60mph/vkr_trng/trng/hardware/01_thermal.md

# Схема №1 — Тепловой шум на 1 МОм + LM358

## BOM

| Поз. | Деталь | Кол-во | Из общего каталога |
|---|---|---|---|
| U1 | LM358P | 1 | да |
| R_n  | Резистор 1 МОм 0.25 Вт 1% | 1 | да |
| R1, R2 | Резистор 10 кОм | 2 | да (делитель V_mid)|
| R_g1 | Резистор 1 кОм | 1 | да (gain каскада 1)|
| R_f1 | Резистор 1 МОм | 1 | да (gain каскада 1)|
| R_g2 | Резистор 10 кОм | 1 | да (gain каскада 2)|
| R_f2 | Резистор 1 МОм | 1 | да (gain каскада 2)|
| C1 | Электролит 10 мкФ | 1 | да (V_mid bypass)  |
| C2 | Электролит 10 мкФ | 1 | да (AC-связь) |
| C3 | Керамика 0.1 мкФ | 1 | да (питание U1) |

Итого: 1× LM358, 7× резисторов, 2× электролита, 1× керамика.

## Расчёт коэффициента усиления

- Каскад 1 (неинвертирующий): Au1 = 1 + R_f1/R_g1 = 1 + 1 МОм / 1 кОм = **1001**.
- Каскад 2 (неинвертирующий): Au2 = 1 + R_f2/R_g2 = 1 + 1 МОм / 10 кОм = **101**.
- Итого Au = ~10⁵.

При e_t = 12,8 мкВ_rms (R=1 МОм, Δf=10 кГц, T=300 К) на выходе ожидаем
≈ 1,3 В_rms. У **LM358** при +5 В верхняя граница выхода типично **V_cc − 1,5 В**
(≈3,5 В), поэтому положительные полупериоды около V_mid могут **слегка клипповать** —
см. «Известные проблемы». При перегрузе уменьшайте Au (например R_f1 = 100 кОм).

## Принципиальная схема (ASCII)

```
              5V o─────┬──── R1 (10k) ──┬──── R2 (10k) ───┐
                       │                │                  │
                       │                │  V_mid = 2.5V    │
                       │                ├── C1 (10µF) ─── GND
                       │                │
                       │                │                ┌── 5V
                       │                │   ┌────────────┤
                       │                │   │  LM358(A)  │
              R_n      │   ┌── R_g1 ──┐ │   │            │
        ┌── (1M) ──┐   │   │          │ │   │ 1: OUT_A ──┼── через C2 (10µF) ── R_g2(10k) ─┐
   GND──┤          ├───┴───┤+IN(3) ───┘ │   │ 2: -IN_A ──┘                                  │
        │          │           │        │   │ 3: +IN_A ────────────────────────────────────│
        └──────────┘           └── R_f1(1M) ┤ 4: V-(GND) │                                  │
                                            │ 5: +IN_B ──┐                                  │
                                            │ 6: -IN_B ──┤                                  │
                                            │ 7: OUT_B ──┴── к A0 Arduino                   │
                                            │ 8: V+(5V) ─── C3(0.1µF) ── GND                │
                                            └─────────────┘                                  │
                                                          R_f2(1M) ─────────── -IN_B────────┘
```

## Сборка по шагам

1. Установите LM358 в DIP-8 разъём на MB-102 (между разделами).
2. Сформируйте V_mid: R1, R2 (делитель 5В→2,5В), C1 (10µF) от V_mid к GND.
3. Соберите источник теплового шума: один вывод R_n к GND, другой — к +IN_A
   (пин 3) **через короткие соединения** и **обязательно экранированный
   участок макетной платы** (например, обнесите проводом, заземлённым на GND).
4. Резистор обратной связи R_f1 (1 МОм) между OUT_A (1) и -IN_A (2).
5. R_g1 (1 кОм) между -IN_A (2) и V_mid.
6. AC-связь C2 (10µF, плюс к выходу 1, минус — к R_g2). С другой стороны
   R_g2 — к -IN_B (6). +IN_B (5) — к V_mid.
7. R_f2 (1 МОм) между OUT_B (7) и -IN_B (6).
8. OUT_B (7) → A0 Arduino.
9. **Питание U1**: V+ (8) → 5V, V- (4) → GND, керамика 0,1µF между 8 и GND
   максимально близко к корпусу.

## Проверка перед запуском

- Мультиметром: на V_mid — 2,5 В ± 0,1.
- На OUT_A в покое — 2,5 В ± 0,5 (не должен прижиматься к 0 или 5).
- На OUT_B в покое — 2,5 В ± 0,5.
- Осциллограф (если есть) на OUT_B: ожидаемая амплитуда ~0,5...2,5 В пик-пик
  при +5 В и LM358 (запас до верха рельсы ~3,5 В); при клиппинге снизить Au.

## Известные проблемы

- **Выход LM358 не доходит до +5 В**: типично максимум **~V_cc − 1,5 В**. Смещение
  на **V_mid ≈ 2,5 В** остаётся корректным; при клиппинге сверху уменьшить Au или
  подобрать R_f1/R_f2.
- **Входной ток смещения** LM358 (намного выше, чем у JFET-ОУ) на **мегомном**
  узле **+IN_A** даёт **DC-сдвиг** — при необходимости добавьте подтяжку **V_mid → +IN_A**
  высоким R (см. обсуждение в README/сборке) или уменьшите номинал R_n-ветки по приоритету шума.
- **Самовозбуждение / шум питания** при слабой развязке. Помогает: увеличить C3 до
  1 мкФ керамики, ставить дополнительный 10 мкФ электролит у +5В.
- **Сетевая наводка 50 Гц**. Помогает: укоротить провода R_n до 1–2 см,
  переместить плату подальше от блоков питания, отключить заряжающее USB на
  ноутбуке.
- **Насыщение** одного из каскадов — на выходе постоянно 0 или у верхнего потолка
  LM358. Уменьшить Au_total до 10⁴ (**R_f1 = 100 кОм**), убедиться, что V_mid стабилен.
