60mph/vkr_trng/trng/hardware/02_zener.md

# Схема №2 — Шум стабилитрона 5,1 В

## BOM

| Поз. | Деталь | Кол-во |
|---|---|---|
| D1 | Стабилитрон 5,1 В 1 Вт | 1 |
| U1 | LM358P | 1 |
| R_b | Резистор 100 кОм | 1 (балласт стабилитрона) |
| R1, R2  | Резистор 10 кОм | 2 (V_mid) |
| R_g1 | Резистор 1 кОм | 1 |
| R_f1 | Резистор 100 кОм | 1 |
| R_g2 | Резистор 1 кОм | 1 |
| R_f2 | Резистор 10 кОм | 1 |
| C_in | Электролит 10 мкФ (AC-связь источника) | 1 |
| C2 | Электролит 10 мкФ (AC-связь между каскадами) | 1 |
| C1, C3  | Керамика 0,1 мкФ | 2 |

## Расчёт

- I_z = (Vin − U_z) / R_b = (9 − 5,1) / 100k ≈ **39 мкА** — режим в самой
  "шумной" зоне нестабильного пробоя.
- Au1 = 1 + 100k/1k = 101.
- Au2 = 1 + 10k/1k = 11.
- Au_total ≈ 1100 — достаточно, чтобы шум Зенера в десятки мВ_rms попал в
  полосу ADC 0–5 В без насыщения.

## Принципиальная схема

```
   Vin(9V) ──── R_b (100k) ──┬─── катод D1 (5.1V Zener)
                             │       │
                             │      анод D1 ── GND
                             │
                             ├── C_in (10µF, плюс к катоду D1) ─── R_g1 (1k) ──┐
                             │                                                  │
                             │                          LM358(A): +IN_A ←── V_mid
                             │                                  : -IN_A ←──────┤
                             │                                  : OUT_A ──┐    │
                             │                                            │    │
                             │                                R_f1 (100k) │
                             │                                            └────┘
                             │                                  : OUT_A ──── C2 (10µF) ──── R_g2 (1k) ──┐
                             │                                                                          │
                             │                                          LM358(B): +IN_B ←── V_mid     │
                             │                                                : -IN_B ←──────────────── ┤
                             │                                                : OUT_B ──── A0           │
                             │                                                                          │
                             │                                                            R_f2 (10k)    │
                             │                                                                          │
                             └──────────────────────────────────────────────────────────────────────────┘
```

V_mid = 2,5 В формируется делителем R1/R2 + C1 (10 мкФ) на 5 В Arduino.

## Сборка

1. Стабилитрон и R_b — на отдельной паре рельсов "шумной" части макетки,
   подальше от Arduino, чтобы импульсы не наводились на ADC по питанию.
2. Питание 9 В — с пина Vin Arduino (через регулятор Nano выходит на ~ 7,5 В,
   но можно подавать прямо на Vin внешний стабилизированный 9 В).
   **АЛЬТЕРНАТИВА:** питать стабилитрон от батарейки 9 В через тот же R_b,
   полностью развязав её GND с Arduino через конденсатор 100 мкФ.
3. С_in и далее — как в `01_thermal.md`, разница только в номиналах R_f.
4. **ВАЖНО**: между Vin и +5V Arduino желательно поставить ферритовую бусину
   или дроссель, чтобы импульсный шум стабилитрона не попадал на питание AVCC.

## Проверка

- Напряжение на D1 (катод-анод): 4,8...5,4 В (плавает! это норма).
- На OUT_A: ~2,5 В ± 1,0 (видна заметная "флуктуация" даже мультиметром).
- На OUT_B: тот же уровень с ещё большей амплитудой.

## Тонкая настройка

Если шум слишком слабый или сигнал насыщается:

- **Слабый**: увеличить R_b до 220 кОм (точка работает дальше от пробоя),
  затем уменьшить → найти "сладкую зону".
- **Насыщение**: уменьшить R_f1 до 47 кОм, R_f2 до 4,7 кОм.
