60mph/vkr_trng/trng/hardware/08_hybrid.md

# Схема №8 — Гибридный TRNG (уровень 1, на Arduino)

## BOM

Это объединение нескольких источников. Должны быть собраны:

- **MPU-6050** (см. `05_mpu6050.md`).
- **Аналоговый источник на A0**: в этой документации возьмём 02_zener
  (стабилитрон). Но прошивка `08_hybrid` агностична к тому, что именно стоит
  на A0 — можно вместо Зенера подключить тепловой (`01_thermal.md`) или
  BJT (`03_bjt_avalanche.md`).
- **Пин A1** оставляем плавающим (источник 06_floating_adc).

## Подключение

| Что | Куда | Источник |
|---|---|---|
| Выход LM358(B) ZENER | A0 | 02_zener |
| (ничего) | A1 | 06_floating_adc |
| MPU-6050 SDA | A4 | 05_mpu6050 |
| MPU-6050 SCL | A5 | 05_mpu6050 |
| GND/5V | GND/5V | общая шина |

## Особенности

- A0 и A1 находятся РЯДОМ → есть кросс-коррелированный шум. Это ОК для
  XOR-комбинирования: даже если они немного коррелированы, XOR с MPU-6050
  убивает корреляцию.
- Прошивка `08_hybrid` берёт по 8 LSB с каждого источника на байт выхода;
  скорость ~5 КБ/с.

## Уровень 2 (на ПК, после захвата)

Для уровня 2 ничего на железе не меняется — берётся уже захваченные ранее
файлы и через `capture/mix.py --mode sha256` создаётся гибридный поток.
Подробнее — `docs/08_hybrid.md`.
