60mph/vkr_trng/trng/hardware/safety.md

# Правила безопасной работы

Проект работает с напряжениями ≤ 9 В и токами ≤ 50 мА. Это безопасно для
человека, но **не** для компонентов и Arduino. Соблюдайте порядок:

1. **Питание подключаем последним.** Сначала собираем всю схему, проверяем
   её мультиметром на отсутствие коротких замыканий между шинами питания и
   GND, и только потом подаём питание.

2. **Никогда не подавайте на пины Arduino напряжение > 5 В.** Если в схеме
   есть 9 В (для лавинного пробоя BJT/Zener), сигнал перед ADC должен пройти
   через **AC-связь** (конденсатор 1–10 мкФ) и быть **сдвинут к 2,5 В** через
   делитель. Любая постоянная составляющая обрезается.

3. **Защитные диоды на ADC.** Желательно поставить два маломощных кремниевых
   диода (или 1N4148) — один анодом к 5 В, другой катодом к GND, оба соединены
   к пину A0. Это ограничит выбросы при включении/выключении схемы.

4. **Полярность электролитов.** При случайной подаче 9 В на ёмкость в обратной
   полярности — она вспухает / взрывается. Проверяйте маркировку.

5. **LM358 однополярное питание.** Не путайте V+ (8) и V- (4). При перепутывании
   или переполюсовке питания ИС может выйти из строя.

6. **Ёмкость по питанию.** На каждый LM358 рядом с пином 8 ставим керамику 0,1
   мкФ (X7R). Без неё усилитель с большим усилением может самовозбуждаться на ВЧ.

7. **Гальваническая развязка по питанию для NIST-захвата.** Когда снимаете
   длинную последовательность для NIST STS (несколько часов работы), питайте
   Arduino от ноутбука с отключённым зарядным устройством, чтобы исключить
   наводки 50 Гц от сети.

8. **MPU-6050 на 3,3 В логике.** Модуль GY-521 имеет встроенный LDO и
   level shifter, поэтому ему можно подавать 5 В. Но **сами линии I²C на чипе
   MPU-6050 — 3,3 В**. Подтяжки к 3,3 В уже стоят на модуле; не добавляйте свои
   к 5 В.

9. **Не работаем при влажности рук > 80 %**, носим антистатический браслет
   при работе с полупроводниками на макетке (ESD, статика).

10. **Сохранение наработок.** Между экспериментами фотографируйте схему — это
    сильно ускорит описание `hardware/0X_*.md` и попадание правильной картинки
    в дипломную работу.
