60mph/vkr_trng/trng/hardware/04_microphone.md

# Схема №4 — KY-037

## BOM

- Модуль KY-037 (электретный микрофон + LM393 + потенциометр чувствительности).
- 4× провода Dupont (M-F).

Никаких внешних компонентов: KY-037 уже содержит электретный капсюль,
буферный усилитель и компаратор.

## Подключение

| KY-037 пин | Arduino Nano |
|---|---|
| VCC | 5V |
| GND | GND |
| AO | A0 |
| DO | (не подключаем) |

## Настройка

1. После подключения подайте питание.
2. В тишине поверните потенциометр чувствительности так, чтобы вольтметр
   на AO показывал ~ 2,5 В (середина диапазона ADC).
3. При хлопке/звуке стрелка должна заметно уходить в обе стороны (есть
   запас и сверху, и снизу).

## Особенности

- **AC-связь не нужна**: KY-037 уже выдаёт сигнал относительно ~2,5 В (через
  LM393 и нагрузочный резистор).
- **DC-смещение**: при разной чувствительности уровень на AO меняется. Это
  не страшно, потому что в `extract_bits.py --bits 1` используется только LSB.
- **Сетевая наводка 50 Гц** — самый частый артефакт. Ставим Arduino
  подальше от мониторов и блоков питания, экранируем модуль фольгой,
  заземлённой на GND.
