60mph/vkr_trng/trng/hardware/06_floating_adc.md

# Схема №6 — Плавающий ADC

## BOM

Только Arduino Nano. Ни одного внешнего компонента.

## Конфигурация

- Пин **A0 ОСТАВЛЕН В ВОЗДУХЕ** (отключить любые подключения, если они есть).
- Опорное ADC переключено на INTERNAL_1V1 — узкий диапазон опорного
  максимизирует относительное влияние шума.
- Free-running ADC, prescaler 32 (38461 выб/с).

## Что происходит физически

- На входе A0 болтается несколько пФ паразитной ёмкости (вход ATmega328P +
  дорожки макетки).
- Эта ёмкость **подзаряжается** от:
  - тепловой шума S/H-конденсатора;
  - наводок 50 Гц от сети;
  - переключений шин Arduino;
  - Wi-Fi / USB излучений.

Состояние стабилизируется на каком-то значении, около которого хаотично
дрейфует.

## Эксперимент

Прошиваем `06_floating_adc/06_floating_adc.ino` и записываем данные. Никаких
сборочных операций.
