60mph/vkr_trng/vkr/presentation/presentation.tex

\documentclass[14pt,aspectratio=169]{beamer}
\usetheme{default}
\setbeamertemplate{navigation symbols}{}

\usepackage{fontspec}
\IfFontExistsTF{Times New Roman}{%
  \setmainfont{Times New Roman}%
}{%
  \setmainfont{DejaVu Serif}[Scale=0.92]%
}
\usepackage{polyglossia}
\setdefaultlanguage{russian}
\setotherlanguage{english}
\setbeamerfont{frametitle}{family=\rmfamily,size=\large,series=\bfseries}
\setbeamerfont{title}{family=\rmfamily,series=\bfseries}
\setbeamerfont{normal text}{family=\rmfamily}
\renewcommand{\familydefault}{\rmdefault}

\usepackage{graphicx}
\usepackage{booktabs}
\usepackage{array}
\usepackage{tikz}
\usepackage{amsmath}
\usepackage{amssymb}
\graphicspath{{../pandoc_media/media/}}

% Логотип ЯрГУ в левом верхнем углу каждого слайда
\addtobeamertemplate{background canvas}{}{%
  \begin{tikzpicture}[overlay,remember picture]
    \node[anchor=north west,inner sep=0.25cm] at (current page.north west)
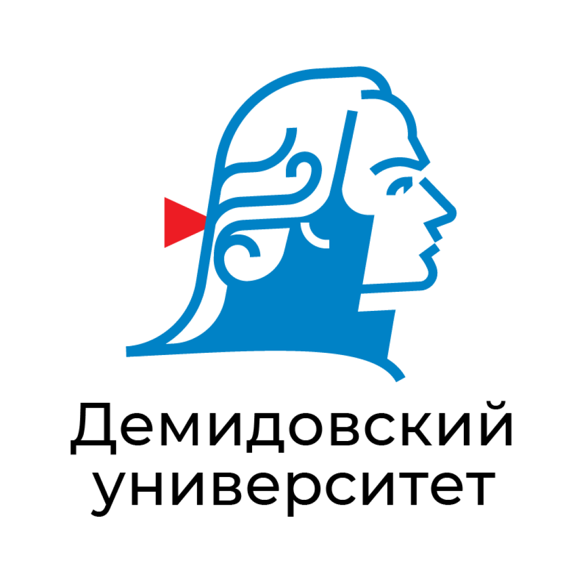
[picture p1: vkr/pandoc_media/media/demid_logo/Logo_demidovskiy_universitet.png]
         {};
  \end{tikzpicture}}

\definecolor{accent}{HTML}{1F3A5F}
\setbeamercolor{frametitle}{fg=accent}
\setbeamercolor{title}{fg=accent}
\setbeamercolor{structure}{fg=accent}
\setbeamercolor{author}{fg=black}
\setbeamercolor{institute}{fg=black}
\setbeamercolor{date}{fg=black}
\setbeamerfont{frametitle}{size=\large,series=\bfseries}
\setbeamertemplate{frametitle}{%
  \vspace{0.6ex}\hspace{1.2cm}\insertframetitle\par%
  \vspace{-0.4ex}{\color{accent}\rule{\linewidth}{0.4pt}}\vspace{0.2ex}}
\setbeamertemplate{footline}{%
  \hfill{\color{gray}\scriptsize\insertframenumber\,/\,\inserttotalframenumber}\hspace{2ex}\vspace{1ex}}
\setbeamertemplate{itemize item}{\color{accent}\textbullet}
\setbeamertemplate{itemize subitem}{\color{accent}\textendash}

\title{Разработка концепции физического\\генератора случайных чисел}
\author{Шестаков Влад Дмитриевич\\Группа ПМИ-41БО}
\institute{ЯрГУ им.\,П.\,Г.\,Демидова\\Математический факультет\\Кафедра математического моделирования}
\date{Ярославль, 2026}

\begin{document}

% ============================================================
\begin{frame}[plain]
  \centering
  \vspace{0.5em}
  {\footnotesize Министерство науки и высшего образования РФ\par
   ЯрГУ им.\,П.\,Г.\,Демидова, математический факультет\par
   Кафедра математического моделирования\par}
  \vfill
  {\color{accent}\rule{0.9\linewidth}{0.6pt}}\par\vspace{0.5em}
  {\large\bfseries\color{accent} Выпускная квалификационная работа\par}
  \vspace{0.5em}
  {\normalsize\bfseries Разработка концепции физического\\генератора случайных чисел\par}
  \vspace{0.4em}
  {\color{accent}\rule{0.9\linewidth}{0.6pt}}\par
  \vfill
  {\footnotesize
  \begin{minipage}[t]{0.48\linewidth}\raggedright
    \textbf{Выполнил:}\\
    студент группы ПМИ-41БО\\
    Шестаков В.\,Д.
  \end{minipage}\hfill
  \begin{minipage}[t]{0.40\linewidth}\raggedright
    \textbf{Научный руководитель:}\\
    старший преподаватель\\
    Савинов Д.\,А.
  \end{minipage}\par}
  \vfill
  {\footnotesize Ярославль, 2026}
\end{frame}

% ============================================================
\begin{frame}{Актуальность}
  \footnotesize
  \begin{itemize}
    \setlength{\itemsep}{0.4em}
    \item Криптография --- повседневная: TLS, мессенджеры, банкинг, IoT, аппаратные кошельки.
    \item Массовые микроконтроллеры (Arduino, ESP32, AVR, STM32 базовых серий) не имеют аппаратного TRNG.
    \item Современные рекомендации по генерации ключевого материала (NIST SP 800-90B и др.) предполагают использование физических источников энтропии.
  \end{itemize}
\end{frame}

% ============================================================
\begin{frame}{Цель и задачи}
  \scriptsize
  \textbf{Цель.} Сравнить доступные источники энтропии (аудио-, радио-, электронные и механические шумы) для проектирования компактного ФГСЧ с учётом:
  \vspace{0.2em}
  \begin{enumerate}
    \setlength{\itemsep}{0.15em}
    \item Критериев NIST STS (тесты на частоту, последовательности, энтропию);
    \item Стоимости и простоты реализации;
    \item Устойчивости к внешним воздействиям.
  \end{enumerate}
  \vspace{0.4em}
  \textbf{Задачи.}
  \vspace{0.2em}
  \begin{enumerate}
    \setlength{\itemsep}{0.15em}
    \item Провести теоретический анализ физических источников энтропии и выбрать наиболее подходящие для компактной реализации.
    \item Собрать экспериментальный стенд на доступной элементной базе (Arduino $+$ ОУ общего назначения) с единым интерфейсом захвата сырого потока.
    \item Реализовать прозрачный (без криптопримитивов) конвейер постобработки и расчёта статистических характеристик.
    \item Достичь прохождения тестов NIST STS при достаточной скорости генерации для практических задач.
  \end{enumerate}
\end{frame}

% ============================================================
\begin{frame}{NIST STS: методология проверки}
  \footnotesize
  \textbf{Нулевая гипотеза} $H_0$: «последовательность порождена идеальным источником --- независимые биты с $\mathbb{P}(b_i{=}1)=1/2$».
  \par\vspace{0.4em}
  Тест вычисляет статистику $T$ и её \textbf{$p$-значение} --- вероятность получить значение статистики не менее экстремальное, чем наблюдаемое, при условии $H_0$. Решающее правило:
  \[
    p\text{-value}<\alpha\ \Rightarrow\ \text{отвергнуть } H_0,\qquad \alpha=0{,}01.
  \]
  \textbf{Пакет NIST STS} (SP 800-22): $15$ групп, $188$ под-тестов.
  \par\vspace{0.4em}
  \textbf{Множественные сравнения.} При большом числе проверок возможны единичные ложные провалы отдельных p-value даже для идеального источника.
  \par\vspace{0.4em}
\end{frame}

% ============================================================
\begin{frame}{NIST STS: классы проверяемых дефектов}
  \scriptsize
  \setlength{\tabcolsep}{4pt}
  \renewcommand{\arraystretch}{1.2}
  \begin{tabular}{|p{0.25\linewidth}|p{0.28\linewidth}|p{0.38\linewidth}|}
    \hline
    \textbf{Класс} & \textbf{Тесты} & \textbf{Что ловит} \\ \hline
    Частотные &
      Frequency, BlockFrequency, CumulativeSums &
      смещение $\hat p_1 \ne 1/2$ на всём потоке и в блоках; дрейф частичных сумм \\ \hline
    Структура серий &
      Runs, LongestRun &
      аномальное число «пробегов»; слишком длинные серии одинаковых битов \\ \hline
    Матричная и спектральная &
      Rank, FFT &
      линейная зависимость внутри битовых матриц; периодические пики в спектре \\ \hline
    Шаблонные &
      NonOverlapping / Overlapping Template, Universal (Maurer) &
      частота заданных битовых паттернов; сжимаемость потока \\ \hline
    Сложностные &
      Linear Complexity, Approximate Entropy, Serial &
      длина минимального LFSR (Берлекэмп--Месси); предсказуемость коротких битовых шаблонов \\ \hline
    Случайные блуждания &
      RandomExcursions, $\ldots$Variant &
      аномальная длительность/число визитов частичной суммы в состояния $\pm k$ \\ \hline
  \end{tabular}
  \par\vspace{0.4em}
  Шесть классов покрывают \emph{разные} типы зависимостей (линейные, нелинейные, спектральные, структурные). Характер провалов позволяет локализовать возможный тип дефекта источника (смещение, корреляция, периодичность, линейная зависимость и т.д.).
\end{frame}

% ============================================================
\begin{frame}{Архитектура стенда}
  \centering
  \begin{minipage}{0.95\linewidth}\centering\footnotesize
    \fbox{\parbox{0.14\linewidth}{\centering Источник\\энтропии}}\,$\to$\,%
    \fbox{\parbox{0.16\linewidth}{\centering Усилитель\\$+$ АЦП}}\,$\to$\,%
    \fbox{\parbox{0.14\linewidth}{\centering Сырой\\$u_{16}$-поток}}\,$\to$\,%
    \fbox{\parbox{0.20\linewidth}{\centering Извлечение МЗР\\$+$ постобработка}}\,$\to$\,%
    \fbox{\parbox{0.16\linewidth}{\centering NIST STS\\$+$ метрики}}
  \end{minipage}
  \vspace{0.6em}
  \footnotesize
  \begin{itemize}\setlength{\itemsep}{0.15em}
    \item \textbf{Аппаратная часть} (источник энтропии $+$ усилитель $+$ АЦП Arduino): единственный требуемый интерфейс наружу --- 16-битные отсчёты через последовательный канал.
    \item \textbf{ПК-конвейер} (Python): захват потока $\to$ извлечение младших разрядов $\to$ постобработка $\to$ анализ (гистограммы, спектральная плотность, автокорреляция, энтропия) $\to$ запуск NIST STS.
    \item Единый бинарный протокол для всех источников $\Rightarrow$ изоморфные эксперименты.
  \end{itemize}
\end{frame}

% ============================================================
\begin{frame}{Источник энтропии}
  \begin{columns}[c]
    \begin{column}{0.52\linewidth}
      \centering
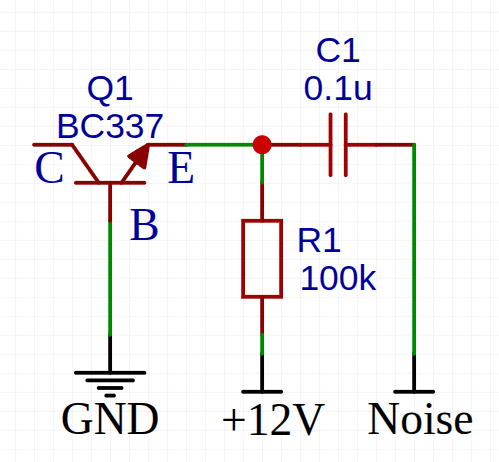
[picture p2: vkr/pandoc_media/media/bjt_noise_source/schema.png]
      
    \end{column}
    \begin{column}{0.46\linewidth}
      \footnotesize
      Лавинный пробой обратносмещённого BE-перехода биполярного транзистора BC337 при $U_{BR}\!\sim\! 9$\,В.
      \par\vspace{0.5em}
      Случайный характер ударной ионизации даёт интенсивный широкополосный шум; сигнал снимается с эмиттера через разделительный конденсатор и подаётся на вход усилителя.
    \end{column}
  \end{columns}
\end{frame}

% ============================================================
\begin{frame}{Аналоговый усилительный тракт}
  \centering
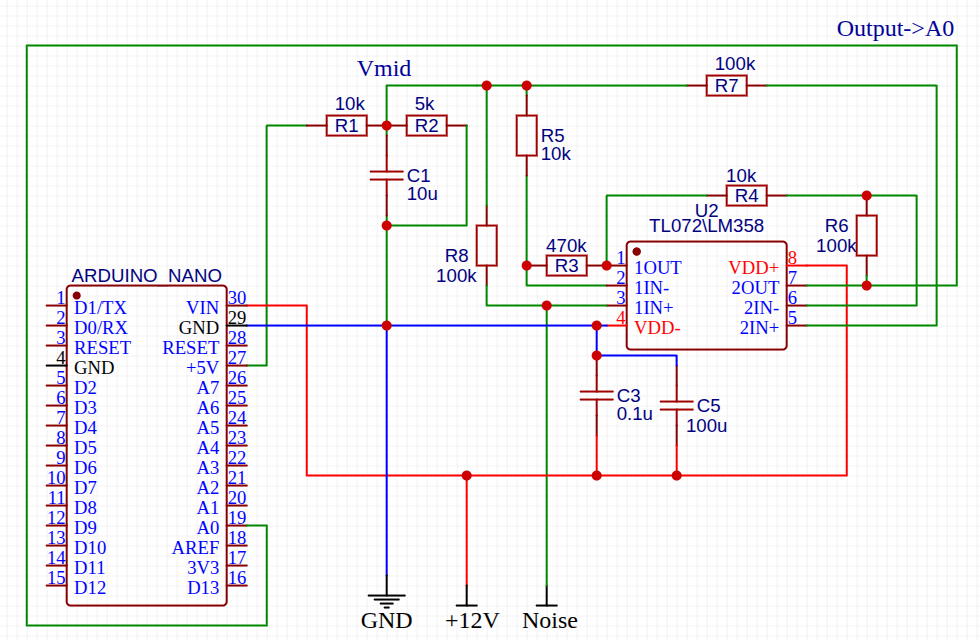
[picture p3: vkr/pandoc_media/media/amplifier_schemas/amp_2stage.png]
  
  \par\vspace{0.3em}
  \footnotesize Двухкаскадный неинвертирующий ($G\approx 528$), $+12$\,В однополярно; оцифровка $10$-битным АЦП Arduino.
\end{frame}

% ============================================================
\begin{frame}{Распределение сырого сигнала}
  \begin{columns}[c]
    \begin{column}{0.55\linewidth}
      \centering
      
    \end{column}
    \begin{column}{0.43\linewidth}
      \footnotesize
      \item Отсчёты $Y_i\!\in\!\{0,\ldots,1023\}$, $N\!\sim\!8{,}5\cdot 10^7$:
      \begin{itemize}\setlength{\itemsep}{0.25em}
        \item Огибающая $\approx$ нормальная (ЦПТ): $\hat\mu\!\approx\!505$, $\hat\sigma\!\approx\!147$.
        \item «Гребёнка» внутри --- следствие нелинейности АЦП.
        \item Согласно критерию Пирсона отвергается гипотеза об идеальной нормальности распределения.
      \end{itemize}
    \end{column}
  \end{columns}
\end{frame}

% ============================================================
\begin{frame}{Анализ сырого битового потока}
  \begin{columns}[c]
    \begin{column}{0.50\linewidth}
      \centering
      
      \par{\tiny АКФ битового потока: $4{,}9\%$ точек вне $95\%$ ДИ ($\approx 5\%$ под $H_0$)}
    \end{column}
    \begin{column}{0.48\linewidth}
      \footnotesize
      \textbf{Дефекты} сырого МЗР канала BJT:
      \begin{itemize}\setlength{\itemsep}{0.15em}
        \item \emph{Смещение:} $\hat p_1 = 0{,}4631$, $\hat\varepsilon \approx \mathbf{3{,}7\cdot 10^{-2}}$
        \item Корреляция мала ($|\hat\rho(1)|\sim 10^{-4}$), но может быть значима при малых лагах --- след ограниченной полосы тракта.
      \end{itemize}
      \vspace{0.3em}
      Задача постобработки --- найти
      $f:\{0,1\}^{n}\to\{0,1\}^{m}$, $m\le n$, такую что $\hat{p}\to 1/2$ и $\rho\to 0$.
      \par\vspace{0.3em}
    \end{column}
  \end{columns}
\end{frame}

% ============================================================
\begin{frame}{Постобработка I: корректор фон Неймана}
  \footnotesize
  \textbf{Идея.} Биты разбиваются на пары $(b_{2i},b_{2i+1})$, к каждой паре применяется правило:
  \[
    (b_{2i},b_{2i+1})\;\to\;
    \begin{cases}
      0, & (0,1) \\ 1, & (1,0) \\ \text{отброс}, & (0,0),(1,1).
    \end{cases}
  \]
  \textbf{Утверждение}. \emph{Если $b_i$ \textbf{независимы} и $\mathbb{P}(b_i{=}1)=p$, выход строго несмещён.}\\
  \emph{Доказательство.} $\mathbb{P}(01)=\mathbb{P}(10)=p(1-p)$ $\Rightarrow$ $\mathbb{P}(b'{=}0)=\mathbb{P}(b'{=}1)=1/2$ при любом $p\in(0,1)$. $\blacksquare$
  \par\vspace{0.3em}
  \par\vspace{0.3em}
  \textbf{Скорость:} $\eta=p(1-p)\le 1/4$ выходных бит на входной; при $p=1/2$ ровно $1/4$ (потери по скорости $\approx 75\%$).
  \par\vspace{0.3em}
  \textbf{Результат на BJT:} $\hat\varepsilon$: $3{,}7\cdot 10^{-2}\to 6{,}5\cdot 10^{-5}$ (сжатие $\sim\!570\times$); 13/15 NIST STS.
\end{frame}

% ============================================================
\begin{frame}{Тесты <<случайных блужданий>>}
  \footnotesize
  Рассмотрим частичную сумму:
  \[
    S_n=\sum_{i=1}^{n}(2b_i-1),\qquad S_n\in\mathbb{Z}.
  \]
  Это симметричное случайное блуждание $\{S_n\}$ на $\mathbb{Z}$ с шагом $\pm 1$.
  \par\vspace{0.3em}
  Тесты \textbf{RandomExcursions} и \textbf{RandomExcursionsVariant} проверяют распределение числа посещений состояний $k\in\{-9,\ldots,-1,1,\ldots,9\}$ на одном «цикле» --- участке между двумя нулями $S_n$.
  \par\vspace{0.4em}
  \textbf{Дефекты после VN:}
  \begin{itemize}\setlength{\itemsep}{0.1em}
    \item крошечное остаточное смещение от нарушенной симметрии $\mathbb{P}(01)\!=\!\mathbb{P}(10)$;
    \item структурная корреляция между парами.
  \end{itemize}
  Оба эффекта искажают длины циклов и распределение посещений $\Rightarrow$ нужна \emph{вторая} ступень --- декорреляция.
\end{frame}

% ============================================================
\begin{frame}{Постобработка II: XOR-децимация}
  \footnotesize
  \[
    b'_j = \bigoplus_{k=0}^{n-1} b_{nj+k}, \qquad n=8.
  \]

  \textbf{Основная роль --- декорреляция.} Усреднение локальных зависимостей внутри окна; соседние выходные биты опираются на \emph{непересекающиеся} окна $\Rightarrow$ корреляция между ними падает на порядки.

  \textbf{Дополнительно --- устранение остаточного смещения} по утверждению об умножении смещений:
  \[
    \mathbb{P}\!\Big(\bigoplus_{k=1}^{n} b_k = 1\Big)
    = \tfrac12 + 2^{\,n-1}\prod_{k=1}^{n}\varepsilon_k
    \quad \xrightarrow{n\to\infty} \quad \tfrac12.
  \]

  \textbf{Итого каскад:} фон Нейман $\to$ XOR-децимация (окно 8).
\end{frame}

% ============================================================
\begin{frame}{Главный результат}
  \begin{columns}[c]
    \begin{column}{0.55\linewidth}
      \centering
      \begin{minipage}{0.92\linewidth}\centering
        \fcolorbox{accent}{white}{\parbox{0.94\linewidth}{\centering\Large
        \vspace{0.4em}\textbf{\color{accent} NIST STS}\par
        \vspace{0.3em}{\Huge\bfseries 15 / 15}\par
        \vspace{0.1em}{\normalsize FAIL\,=\,0,\ N/A\,=\,0}\par\vspace{0.4em}}}
      \end{minipage}
      \par\vspace{0.6em}
      \footnotesize
      Каскад: фон Нейман $\to$ XOR-децимация (окно 8)\\
      $\hat H_\infty \approx 0{,}99980$ бит/бит (точечная);\\
      $H_\infty \ge 0{,}99863$ бит/бит (MCV, NIST SP 800-90B);\\
      пропускная способность $\sim 1{,}6$\,кбит/с;\\
      выход \emph{прозрачен} (без криптопримитивов).
    \end{column}
    \begin{column}{0.43\linewidth}
      \centering
      
      \par\vspace{0.2em}{\Large\color{accent}$\downarrow$}\par\vspace{0.2em}
      
      \par\vspace{0.05em}{\tiny фрагмент итогового битового потока}
    \end{column}
  \end{columns}
\end{frame}

% ============================================================
\begin{frame}{Сравнение источников}
  \centering
  \footnotesize
  \setlength{\tabcolsep}{6pt}
  \renewcommand{\arraystretch}{1.3}
  \begin{tabular}{|p{0.36\linewidth}|c|c|c|c|}
    \hline
    \textbf{Канал} & $\sigma_\mathrm{adc}$ & \textbf{NIST} & $H_\infty$ & \textbf{бит/с} \\
    \hline
    \textbf{BJT + VN + XOR-Decim} & $147$ & \textbf{15 / 0} & $0{,}99981$ & ${\sim}\,1{,}6{\cdot}10^3$ \\
    \hline
    BJT + VN & $147$ & 13 / 2 & $0{,}99981$ & ${\sim}\,1{,}3{\cdot}10^4$ \\
    \hline
    Тепловой шум $10$\,МОм & $15$ & 10 / 5 & $0{,}99923$ & ${\sim}\,1{,}5{\cdot}10^4$ \\
    \hline
    Микрофон KY-037 & $1$ & 4 / 11 & $0{,}99945$ & ${\sim}\,7{,}5{\cdot}10^3$ \\
    \hline
    MPU-6050 & --- & 2 / 13 & $0{,}58478$ & ${\sim}\,5{,}6{\cdot}10^3$ \\
    \hline
    Плавающий АЦП & $5$ & 0 / 15 & $0{,}99943$ & ${\sim}\,2{\cdot}10^2$ \\
    \hline
    Clock jitter & --- & 0 / 15 & $0{,}99966$ & ${\sim}\,30$ \\
    \hline
  \end{tabular}
\end{frame}

% ============================================================
\begin{frame}{Выводы}
  \footnotesize
  \textbf{Выполнено:}
  \begin{itemize}\setlength{\itemsep}{0.2em}
    \item теоретический анализ восьми классов физических источников энтропии;
    \item собран стенд и проведена натурная проверка шести каналов;
    \item разработаны и обоснованы пять алгоритмов постобработки;
    \item все каналы оценены по NIST STS, $H_\infty$ и скорости генерации.
  \end{itemize}
  \vspace{0.4em}
  \textbf{Главные результаты:}
  \begin{itemize}\setlength{\itemsep}{0.2em}
    \item обоснование каскада: фон Нейман строго устраняет смещение, XOR-децимация экспоненциально подавляет остаток и краткосрочные корреляции;
    \item на канале BJT с каскадной постобработкой получено \textbf{15 / 15 NIST STS} без криптопримитивов; стоимость элементной базы $<50$\,руб.
  \end{itemize}
\end{frame}

% ============================================================
\begin{frame}{Перспективы}
  \begin{itemize}
    \setlength{\itemsep}{0.7em}
    \item Встроенный \emph{health-мониторинг} в реальном времени (тесты SP 800-90B прямо в прошивке) для детектирования деградации источника на ходу.
    \item XOR-смешение нескольких независимых каналов как ещё один уровень --- пропускная способность не теряется, $H_\infty$ монотонно растёт.
    \item Перенос каскада постобработок на микроконтроллер.
  \end{itemize}
\end{frame}

\end{document}
