60mph/vkr_trng/trng/hardware/03_bjt_avalanche.md

# Схема №3 — Лавинный пробой BE-перехода BJT

## BOM

| Поз. | Деталь | Кол-во |
|---|---|---|
| Q1 | NPN BJT (2N3904 рекомендуется), коллектор N/C | 1 |
| U1 | LM358P | 1 |
| R_b | Резистор 470 кОм | 1 (ограничение тока пробоя) |
| R1, R2  | Резистор 10 кОм | 2 (V_mid) |
| R_g1 | Резистор 1 кОм | 1 |
| R_f1 | Резистор 1 МОм | 1 |
| R_g2 | Резистор 1 кОм | 1 |
| R_f2 | Резистор 10 кОм | 1 |
| C_in | Электролит 1 мкФ | 1 (AC-связь, маленькая для большой полосы)|
| C2 | Электролит 10 мкФ | 1 |
| C1, C3  | Керамика 0,1 мкФ | 2 |

## Идея

Подаём на эмиттер положительное напряжение 9 В через большой резистор R_b
(470 кОм). База — в воздухе по постоянному току (через 1 МОм утечка к V_mid +
AC-связь). Коллектор — не подключён.

Когда U_BE_reverse > U_breakdown (для 2N3904: ~7–9 В), переход пробивается
и в нём идут лавинные процессы. Ток ~1–10 мкА сильно "прыгает", это и
снимаем как сигнал.

## Принципиальная схема

```
   Vin(9V) ──── R_b (470k) ─────┬── E (Q1, эмиттер)
                                │
                                B (база) ─── C_in (1µF, плюс к B) ── R_g1 (1k) ──┐
                                                                                  │
                                                       LM358(A): +IN_A ←── V_mid │
                                                              : -IN_A ←──────────┤
                                                              : OUT_A ──┐        │
                                                                        │        │
                                                          R_f1 (1M)     │        │
                                                              ──────────┘        │
                                                              : OUT_A ──── C2 (10µF) ── R_g2 (1k) ──┐
                                                                                                    │
                                                                            LM358(B): +IN_B ← V_mid │
                                                                                  : -IN_B ←─────── ┤
                                                                                  : OUT_B ── A0    │
                                                                          R_f2 (10k)               │
                                                                                                    │
                                              C ──── (не подключаем!)                              │
                                                                                                    │
                                              Q1: NPN; коллектор N/C, эмиттер на R_b, база — наша точка съёма.

   Подтяжка к V_mid через 1 МОм (опционально): база──1М──V_mid (стабилизирует постоянный потенциал)
```

## Сборка

1. **Селекция Q1**: подайте 9 В на эмиттер через R_b, измерьте мультиметром
   напряжение на базе при разомкнутой остальной цепи. Если оно "плавает"
   в районе 1–2 В — пробой есть, экземпляр годен. Если стоит на 0 В или
   на 9 В — пробой не достигнут, попробуйте другой образец или поднимите
   напряжение питания (но не выше +12 В без дополнительной защиты Arduino!).
2. Установите выбранный Q1 на отдельной зоне макетки.
3. Подключите ту же цепь усиления, что и для Зенера (`02_zener.md`), но с
   R_f1 = 1 МОм (Au1 = 1001) — амплитуда сырого сигнала меньше.
4. Сначала проверьте без C_in: на базе должно быть колеблющееся
   1–2 В (в покое). Потом подключите C_in.

## Проверка

- При исправной работе на OUT_B видна сильная "болтовня" сигнала ~ 0…5 В
  пик-пик (часто с явными "иглами" — это и есть лавинные импульсы).

## Особенности

- **Старение**: после нескольких часов работы в режиме пробоя транзистор
  может деградировать — спектр сигнала "розовеет", амплитуда падает.
  При длинных сеансах меняем образец.
- **Температурная зависимость**: при нагреве U_breakdown снижается. Если
  Arduino греет всю плату, стоит подождать 5–10 минут после включения, чтобы
  стенд "устоялся".
