60mph/vkr_trng/vkr/presentation/speech.md

# Текст выступления — 9 минут

Формат: **жирным** — что произносим вслух; *курсив в скобках* — пояснения из ВКР для контекста (не читаются, нужны на случай вопросов или если темп идёт быстрее).

Темп: ≈130 слов/мин (∼9 мин = 1170 слов). Хронометраж по слайду указан в заголовке.

---

## Слайд 1. Титул (≈15 с)

**Уважаемые члены комиссии! Меня зовут Шестаков Влад, представляю выпускную квалификационную работу на тему «Разработка концепции физического генератора случайных чисел». Научный руководитель — старший преподаватель Дмитрий Александрович Савинов.**

---

## Слайд 2. Актуальность (≈55 с)

**Случайные числа — основа всей современной криптографии: ключи шифрования, инициализация TLS, мессенджеры, банковские транзакции, IoT-устройства, аппаратные кошельки. Миллиарды ключей в год.**

**При этом массовые микроконтроллеры — Arduino, ESP32, базовые серии AVR и STM32 — не имеют встроенного аппаратного TRNG.**

**Современные стандарты — NIST SP 800-90B и ГОСТ Р 34.10 — прямо требуют физического источника энтропии для ключевого материала; чисто алгоритмический генератор для криптографических целей неприемлем.**

**Цена ошибки хорошо известна: в 2012 году дефект генератора в Android привёл к тому, что около 86 процентов биткойн-ключей на уязвимых устройствах оказались предсказуемыми. Атака ROCA сделала уязвимыми миллионы сертифицированных TPM-модулей Infineon.**

*(Программные генераторы детерминированы: при знании семени весь поток воспроизводим без физического доступа к устройству. В Android-инциденте семя в SecureRandom фактически содержало мало энтропии из-за бага. ROCA — уязвимость в алгоритме генерации ключевых пар RSA внутри библиотеки Infineon: ключи можно факторизовать. Это и обосновывает задачу — собрать собственный TRNG на доступной базе.)*

---

## Слайд 3. Цель и задачи (≈30 с)

**Цель работы — сравнить физические источники энтропии и на этой основе спроектировать компактный аппаратный TRNG, удовлетворяющий критериям случайности по пакету NIST STS при минимальной стоимости и простоте реализации.**

**Задачи: теоретический анализ восьми классов источников, сборка стенда на доступной элементной базе, практическая проверка шести каналов, оценка по NIST STS, скорости генерации и стоимости.**

---

## Слайд 4. Классификация ГСП (≈25 с)

**Все генераторы делятся на два класса. ГПСП — программные псевдослучайные: выход полностью определяется алгоритмом и начальным значением, при знании семени — предсказуем. ГИСП — истинные физические: основаны на недетерминированном процессе. Именно второй класс — предмет работы.**

*(ГПСП могут давать статистически качественный поток — линейные конгруэнтные, Mersenne Twister, криптографические PRNG — но без физической энтропии в семени они в принципе не могут быть TRNG. ГИСП извлекают непредсказуемость прямо из физики: тепловой шум, квантовый эффект, лавинный пробой.)*

---

## Слайд 5. Физические источники энтропии (≈35 с)

**В теоретической части рассмотрены восемь классов источников. Электронные: тепловой шум Джонсона–Найквиста, дробовой шум, лавинный шум обратного пробоя полупроводникового перехода, мерцающий шум вида один на эф. Прочие: оптические и квантовые источники, радиоактивный распад, акустические шумы и MEMS-инерциальные датчики.**

**Для каждого рассмотрена физическая модель, спектральная характеристика и применимость в массовой реализации.**

*(Тепловой шум — белый, мощность kTRΔf, есть в любом резисторе. Дробовой — связан с дискретностью заряда, наблюдается в p-n переходах. Лавинный — ударная ионизация при обратном смещении выше U_BR, имеет наибольшую амплитуду. Мерцающий 1/f — нежелательный, доминирует на низких частотах. Квантовые и радиоактивные источники — самые «чистые», но требуют сложного оборудования. Акустические и MEMS — зависят от среды.)*

---

## Слайд 6. Архитектура стенда (≈40 с)

**Стенд построен по модульной архитектуре: разные физические источники изолированы, но проходят через единый конвейер. Аппаратная база — Arduino Nano с микроконтроллером ATmega328P. Источник шума усиливается аналоговым трактом на операционном усилителе, оцифровывается АЦП, по последовательному каналу на скорости один мегабод передаётся на ПК. На стороне ПК — извлечение младших разрядов, постобработка, статистический анализ, прогон NIST STS.**

*(Каждый источник имеет свою прошивку, но единый бинарный протокол — uint16 little-endian с ASCII-баннером метаданных. Reasonовая скорость один мегабод — это «родная» для UART ATmega328P на 16 МГц, ноль процентов ошибки делителя. Эффективная частота отсчётов ≈49,6 кГц, упирается именно в линию связи. На ПК конвейер реализован на Python.)*

---

## Слайд 7. Аналоговый усилительный тракт (≈40 с)

**Аналоговый тракт реализован как двухкаскадный неинвертирующий усилитель на сдвоенном ОУ LM358 при однополярном питании двенадцать вольт. Опорное напряжение смещения формируется отдельным делителем от шины пять вольт Arduino. Каскады соединены через резистор, без разделительного конденсатора — чтобы сохранить низкочастотные составляющие сигнала. Суммарный коэффициент усиления — порядка пятисот.**

*(Каждый каскад — типовое включение «1+Rf/Rg». Первый каскад: Rg=10к, Rf=470к, G1≈48. Второй: Rg=10к, Rf=100к, G2≈11. Итог: G≈528. LM358 выбран потому, что его выход доходит до нижней шины — это позволяет использовать весь диапазон АЦП 0–5В даже при питании ОУ от +12В. TL072 — тише по шуму, но не rail-to-rail, и в однополярном режиме срезает нижние 1,5–2 вольта диапазона; поэтому использовался только в тепловом канале, где собственный шум ОУ важнее динамики.)*

---

## Слайд 8. Лавинный пробой BE-перехода (≈40 с)

**Основным предметом исследования стал канал лавинного шума обратносмещённого BE-перехода биполярного транзистора BC337. Транзистор включён инвертированно: коллектор и база на землю, эмиттер через балластный резистор сто килоом подтянут к двенадцати вольтам. При таком напряжении BE-переход выходит в режим лавинного пробоя, и случайный характер ударной ионизации даёт интенсивный широкополосный шум. Полезный сигнал снимается с эмиттера через разделительный конденсатор и подаётся на вход усилителя.**

*(Изначально пробовался 2N3904, но он не вышел в лавинный режим даже при +12В — паспортный диапазон U_BR относится к худшему случаю, фактические экземпляры могут пробиваться выше типового. BC337 устойчиво заработал. Балластный 100кОм ограничивает ток лавины ~10–50 мкА. Конденсатор 0,1мкФ отрезает постоянную составляющую ≈U_BR на эмиттере, иначе вход усилителя был бы перегружен DC.)*

---

## Слайд 9. Развитие ГИСП на основе BJT (≈60 с)

**Канал BJT прошёл четыре итерации.**

**Этап 1 — одиночный каскад с усилением около пятидесяти: сигнал занимает лишь пятую часть шкалы АЦП.**

**Этап 2 — добавление второго каскада, усиление выросло до пятисот двадцати восьми, размах достиг полной шкалы, но появилась систематическая аномалия — насыщение на верхней границе АЦП.**

**Этап 3 — две согласованные правки: смещение опорного напряжения вниз и снижение усиления (добавочный 680 килоом параллельно резистору обратной связи второго каскада, общий коэффициент упал примерно до четыреста шестидесяти семи). Насыщение исчезло; именно снижение усиления, а не само устранение насыщения, объясняет уменьшение сигмы со 145 до 122.**

**Этап 4 — добавочный резистор снят, усиление возвращено к пятьсот двадцати восьми, плюс введена развязка по питанию двумя конденсаторами и применён более стабильный лабораторный блок питания. Эта конфигурация принята как итоговая.**

*(V_mid смещён до ≈1,67В путём добавления второго 10к параллельно нижнему плечу делителя — без перепайки уже собранной платы. Качество разных блоков питания оценивалось тем же измерительным трактом: вместо источника шума на вход подавалась шина +12В через 0,1мкФ — конденсатор отрезает постоянку, а пульсации усиливаются ×500 и видны в реальном времени в «осциллографе» serial_scope. Это позволило выбрать самый «тихий» БП без отдельного осциллографа.)*

---

## Слайд 10. Постобработка битового потока (≈50 с)

**Базовый алгоритм — схема фон Неймана. Это прозрачный, некриптографический экстрактор без параметров и начального состояния. Выбор именно его обоснован целью работы: оценить качество физического источника, а не замаскировать его дефекты криптографическим хэшем — SHA-256 прошёл бы NIST STS почти при любом входе.**

**Помимо фон Неймана исследованы четыре других алгоритма: XOR с задержкой N, XOR нескольких младших разрядов одного отсчёта, XOR-децимация с окном N, и побайтовая XOR-свёртка. Все они применялись либо как самостоятельные методы, либо как второй проход поверх фон Неймана.**

*(Фон Нейман — теорема 1951 года: при независимости пар бит выход строго несмещён. Цена — потеря пропускной способности (≈25% при равных вероятностях, меньше при смещении). Второй проход нужен потому, что фон Нейман снимает только bias на парах, но не убирает длинно-временных корреляций от полосы усилителя. Каскад «фон Нейман → XOR-децимация» как раз и устраняет эти остатки.)*

---

## Слайд 11. Главный результат (≈60 с)

**Главный результат работы: на итоговом канале BJT с каскадной постобработкой — фон Нейман плюс XOR-децимация с окном восемь — получено пятнадцать PASS из пятнадцати групп тестов NIST STS, при нулевом числе провалов и нулевом числе неприменимых тестов.**

**То есть построенный из дешёвых компонентов и без криптографических библиотек источник по статистике полностью совпадает с эталонной случайной последовательностью.**

**Минимальная энтропия выходного потока — девять девяток после запятой бита на бит, скорость генерации — около полутора килобит в секунду, стоимость элементной базы — менее пятидесяти рублей.**

*(15 PASS из 15 — включая RandomExcursions и RandomExcursionsVariant, которые на одиночном фон Неймане проваливаются как раз из-за остаточных структурных корреляций. Скорость 1,6 кбит/с — после двух последовательных сжатий: фон Нейман сжимает ≈в 4 раза, XOR-децимация — ещё в 8 раз, итого ≈ ×32 от исходных ~50 тыс. бит/с. На картинке справа — фрагмент 512×512 итогового битового потока, визуально неотличим от белого шума.)*

---

## Слайд 12. Сравнение источников (≈45 с)

**Сводная сравнительная таблица всех шести проверенных каналов. Канал BJT с каскадной постобработкой — выделен — даёт одновременно полное прохождение NIST STS, минимальную энтропию выше девяти девяток и низкую стоимость. Тепловой канал — устойчивый средний результат, 10 из 15 PASS, но амплитуда сигнала на порядок ниже. Микрофон, MPU-6050, плавающий АЦП и канал дрожания тактов в наблюдаемой реализации непригодны как самостоятельные источники.**

*(Плавающий АЦП и clock jitter формально имеют min-H около 0,9999 — то есть на бит после фон Неймана энтропия близка к идеальной, — но NIST провален весь, потому что бит-энтропия не учитывает структурных корреляций. Это методическое предупреждение: высокая min-H не гарантирует прохождения NIST. Микрофон и MPU — слабы по другой причине: узкая полоса и низкое использование диапазона АЦП.)*

---

## Слайд 13. Выводы (≈30 с)

**По результатам работы: сконструирован стенд, проверены шесть независимых источников энтропии. Лучший результат — канал лавинного шума BJT с каскадной постобработкой: пятнадцать PASS из пятнадцати NIST STS. Показано, что двухступенчатая некриптографическая постобработка эквивалентна криптографическому отбеливанию по эффекту на NIST. Стоимость элементной базы итогового источника — менее пятидесяти рублей.**

---

## Слайд 14. Перспективы (≈15 с)

**Перспективы: второй независимый канал на отдельной микросхеме ОУ с XOR-смешением битовых потоков; печатная плата с экранированием и малошумящим стабилизатором; упаковка в законченный модуль с собственным микроконтроллером.**

**Спасибо за внимание, готов ответить на вопросы.**

---

## Итоговый хронометраж

| № | Слайд | Длительность |
|---|---|---|
| 1 | Титул | 15 с |
| 2 | Актуальность | 55 с |
| 3 | Цель и задачи | 30 с |
| 4 | Классификация ГСП | 25 с |
| 5 | Физические источники | 35 с |
| 6 | Архитектура стенда | 40 с |
| 7 | Аналоговый тракт | 40 с |
| 8 | Лавинный пробой BJT | 40 с |
| 9 | Развитие ГИСП BJT | 60 с |
| 10 | Постобработка | 50 с |
| 11 | Главный результат | 60 с |
| 12 | Сравнение источников | 45 с |
| 13 | Выводы | 30 с |
| 14 | Перспективы | 15 с |
| **Итого** | | **9 мин 00 с** |
