60mph/vkr_trng/trng/docs/01_thermal.md

# Источник №1 — Тепловой шум (Johnson-Nyquist)

**Раздел дипломной работы:** 2.1, "Тепловой шум".

## Физический принцип

Шум Джонсона-Найквиста на резисторе сопротивлением R при температуре T
имеет среднеквадратичное напряжение в полосе Δf:

\[
\overline{e_t^2} = 4 k T R \, \Delta f
\]

Спектральная плотность плоская (белый шум) до десятков ГГц при комнатной
температуре. Для R = 1 МОм, T = 300 К, Δf = 10 кГц:

- e_rms ≈ 12,8 мкВ;
- спектральная плотность 4 k T R ≈ 1,6·10⁻¹⁴ В²/Гц.

Чтобы вытащить такой сигнал на 10-битный ADC ATmega328P (LSB ≈ 5 мВ при
V_ref=5 В), требуется усиление **≥ 1000**.

## Установка эксперимента (заполняется при сборке)

| Параметр | Значение |
|---|---|
| Дата | |
| Температура помещения, °C | |
| Освещение | |
| Питание | |
| R (источник шума), МОм | 1.0 |
| Усиление каскада 1 | 100× |
| Усиление каскада 2 | 100× |
| Полоса фильтра, кГц | ~30 |
| Опорное ADC | AVCC=5В  |
| Частота дискретизации, Гц | 76923 |
| Длительность записи, мин | |
| Объём raw .bin, МБ | |

Аппаратная часть — см. `hardware/01_thermal.md`.

## Команда запуска

```bash
python scripts/pipeline.py --source 01_thermal --port /dev/ttyUSB0 \
    --bytes 10485760 --bits 1 --sts ./nist_sts/sts-2.1.2
```

## Результаты (заполняются после прогона)

- **Сырая статистика:** mean, std, χ² на равномерность (см. `data/reports/01_thermal/histogram_raw.json`).
- **Спектр PSD:** ожидаем плоский. Если есть пик 50/100 Гц — проблема экранирования.
- **Автокорреляция отсчётов:** ожидаем быстрый спад до уровня шума.
- **Энтропия после LSB+VN:**
  - Шеннон/бит: …
  - min-H/бит: …
  - MCV-min-H/бит (NIST SP 800-90B): …
- **NIST STS** (вставить таблицу из `data/reports/01_thermal/nist/results.md`).

## Обсуждение

(Сравнить с теоретическими ожиданиями, объяснить расхождения; типичные
причины: помехи, насыщение усилителя, недостаточное усиление, сетевые
наводки 50 Гц.)

## Импорт в дипломную работу

После прогона достаточно скопировать таблицу NIST STS, гистограмму и спектр
из `data/reports/01_thermal/` в новый раздел "Результаты эксперимента
с тепловым шумом" внутри `parts/05-chapter2.tex` (раздел 2.1).
