60mph/vkr_trng/trng/docs/05_mpu6050.md

# Источник №5 — MEMS-шум MPU-6050 (акселерометр + гироскоп)

**Раздел дипломной работы:** 2.3, "Гироскопические датчики и акселерометры".

## Физический принцип

В MEMS-сенсорах подвижная масса колеблется относительно ёмкостных пластин.
Любое измерение содержит сумму сигнала и шума:

- **Тепловой шум** механической подвески.
- **Дробовой шум** в зарядо-чувствительном усилителе.
- **Квантование 16-битного ADC**.

При неподвижном датчике "сигнал" минимален, и младшие биты регистров полностью
определяются шумом. Поэтому из 6 датчиков (3 акселерометра + 3 гироскопа) можно
вытащить **6 бит истинной энтропии** с каждого опроса.

## Особенности скорости

- Скорость опроса MPU-6050 на I²C 400 кГц ≈ 700 циклов/с;
- Каждый цикл = 6 LSB бит;
- Итого ≈ **4200 бит/с сырой энтропии** = **525 байт/с**.

Для 1 МБ NIST STS-блока требуется ~32 минуты записи. Для 10 МБ — ~5 часов.
**Это самый медленный источник в проекте** — но и самый интересный с
методологической точки зрения, потому что он напрямую соответствует разделу
2.3 дипломной работы.

## Установка эксперимента

| Параметр | Значение |
|---|---|
| Дата | |
| Положение модуля | неподвижный  |
| Виброизоляция (есть/нет)| |
| Конфигурация AFS_SEL | 3 (±16 g) |
| Конфигурация FS_SEL | 3 (±2000°/с) |
| DLPF | 0 (max BW) |
| SMPLRT_DIV | 0 (8 кГц) |
| Длительность записи, мин| |

Аппаратная часть — `hardware/05_mpu6050.md`.

## Команда запуска

```bash
python scripts/pipeline.py --source 05_mpu6050 --port /dev/ttyUSB0 \
    --bytes 1048576 --bits 6 --sts ./nist_sts/sts-2.1.2
```

(Используем `--bits 6`, потому что в 6 младших разрядах ВСЕГО u16 уже лежат
6 LSB; не нужно дополнительной экстракции.)

## Результаты (заполняются после прогона)

(...)

## Известные проблемы

- При движении / вибрации появляется сильный сигнал, который **корреллирует**
  биты — провал NIST STS Frequency Test. Для записи фиксируем модуль на
  столе.
- **Температура чипа** влияет на смещение нулей. Перед записью даём чипу
  прогреться ~5 минут.

## Импорт в дипломную работу

Подраздел 2.3, "MEMS-ГИСП".
