60mph/vkr_trng/vkr/presentation/presentation.pdf

Министерство науки и высшего образования РФ ЯрГУ им. П. Г. Демидова, математический факультет Кафедра математического моделирования

# Выпускная квалификационная работа

## Разработка концепции физического генератора случайных чисел

Выполнил:
студент группы ПМИ-41БО
Шестаков В. Д.

Научный руководитель:
старший преподаватель
Савинов Д. А.

Ярославль, 2026

# Актуальность

- Криптография — повседневная: TLS, мессенджеры, банкинг, IoT, аппаратные кошельки.
- Массовые микроконтроллеры (Arduino, ESP32, AVR, STM32 базовых серий) не имеют аппаратного TRNG.
- Современные рекомендации по генерации ключевого материала (NIST SP 800-90B и др.) предполагают использование физических источников энтропии.

# Цель и задачи

Цель. Сравнить доступные источники энтропии (аудио-, радио-, электронные и механические шумы) для проектирования компактного ФГСЧ с учётом:

1. Критериев NIST STS (тесты на частоту, последовательности, энтропию);
2. Стоимости и простоты реализации;
3. Устойчивости к внешним воздействиям.

Задачи.

1. Провести теоретический анализ физических источников энтропии и выбрать наиболее подходящие для компактной реализации.
2. Собрать экспериментальный стенд на доступной элементной базе (Arduino + ОУ общего назначения) с единым интерфейсом захвата сырого потока.
3. Реализовать прозрачный (без криптопримитивов) конвейер постобработки и расчёта статистических характеристик.
4. Достичь прохождения тестов NIST STS при достаточной скорости генерации для практических задач.

# NIST STS: методология проверки

Нулевая гипотеза H0: «последовательность порождена идеальным источником — независимые биты с P(bi=1) = 1/2».

Тест вычисляет статистику T и её p-значение — вероятность получить значение статистики не менее экстремальное, чем наблюдаемое, при условии H0. Решающее правило:

p-value < α ⇒ отвергнуть H0, α = 0,01.

Пакет NIST STS (SP 800-22): 15 групп, 188 под-тестов.

Множественные сравнения. При большом числе проверок возможны единичные ложные провалы отдельных p-value даже для идеального источника.

# NIST STS: классы проверяемых дефектов

Класс | Тесты | Что ловит
Частотные | Frequency, BlockFrequency, CumulativeSums | смещение pˆ1 ̸= 1/2 на всём потоке и в блоках; дрейф частичных сумм
Структура серий | Runs, LongestRun | аномальное число «пробегов»; слишком длинные серии одинаковых битов
Матричная и спектральная | Rank, FFT | линейная зависимость внутри битовых матриц; периодические пики в спектре
Шаблонные | NonOverlapping / Overlapping Template, Universal (Maurer) | частота заданных битовых паттернов; сжимаемость потока
Сложностные | Linear Complexity, Approximate Entropy, Serial | длина минимального LFSR (Берлекэмп– Месси); предсказуемость коротких битовых шаблонов
Случайные блуждания | RandomExcursions, . . .Variant | аномальная длительность/число визитов частичной суммы в состояния ±k

Шесть классов покрывают разные типы зависимостей (линейные, нелинейные, спектральные, структурные). Характер провалов позволяет локализовать возможный тип дефекта источника (смещение, корреляция, периодичность, линейная зависимость и т.д.).

# Архитектура стенда

Источник
энтропии

→

Усилитель
+ АЦП →

Сырой
u16-поток

→

Извлечение МЗР
+ постобработка →

NIST STS
+ метрики
- Аппаратная часть (источник энтропии + усилитель + АЦП Arduino): единственный требуемый интерфейс наружу — 16-битные отсчёты через последовательный канал.
- ПК-конвейер (Python): захват потока → извлечение младших разрядов → постобработка → анализ (гистограммы, спектральная плотность, автокорреляция, энтропия) → запуск NIST STS.
- Единый бинарный протокол для всех источников ⇒ изоморфные эксперименты.

# Источник энтропии

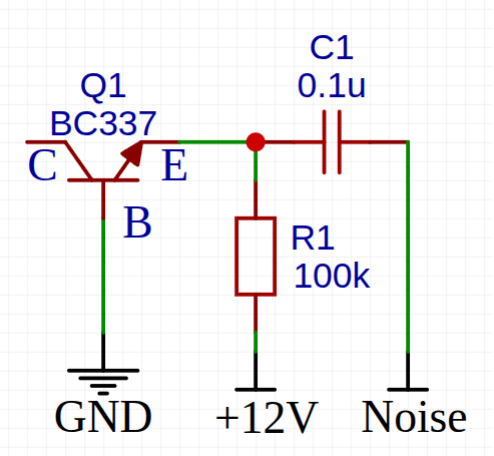
[picture p40: figure]

Лавинный пробой обратносмещённого BE-перехода биполярного транзистора BC337 при UBR ∼9В.

Случайный характер ударной ионизации даёт интенсивный широкополосный шум; сигнал снимается с эмиттера через разделительный конденсатор и подаётся на вход усилителя.

# Аналоговый усилительный тракт


# Распределение сырого сигнала


Отсчёты Yi∈ {0, . . . , 1023}, N∼8,5 · 10⁷
:
- Огибающая ≈ нормальная
(ЦПТ): µˆ≈505, σˆ ≈147.
- «Гребёнка» внутри — следствие нелинейности АЦП.
- Согласно критерию Пирсона отвергается гипотеза об
идеальной нормальности
распределения.

# Анализ сырого битового потока

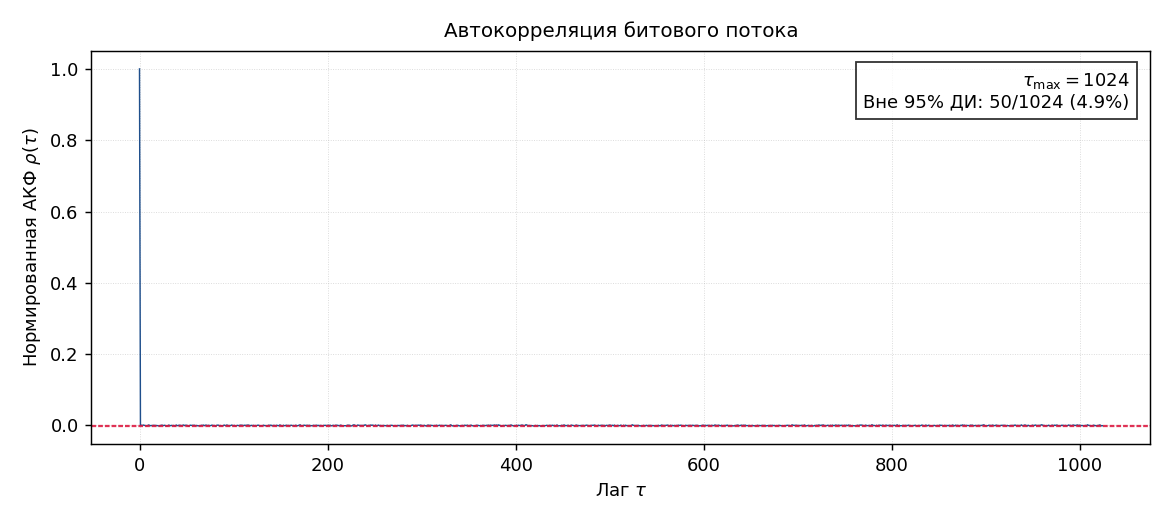
[picture p41: figure]

АКФ битового потока: 4,9% точек вне 95% ДИ (≈ 5% под H0)

Дефекты сырого МЗР канала BJT:

- Смещение: pˆ1 = 0,4631,
εˆ ≈ 3,7 · 10−2
- Корреляция мала (|ρˆ(1)| ∼ 10−4
), но
может быть значима при малых лагах — след ограниченной полосы тракта.

Задача постобработки — найти
f : {0, 1}

n → {0, 1}

m, m ≤ n, такую что
pˆ → 1/2 и ρ → 0.

# Постобработка I: корректор фон Неймана

Идея. Биты разбиваются на пары (b2i

, b2i+1), к каждой паре применяется правило:

(b2i
, b2i+1) →
0, | (0, 1)
1, | (1, 0)
отброс, (0, 0),(1, 1).

Утверждение. Если bi независимы и P(bi=1) = p, выход строго несмещён.
Доказательство. P(01) = P(10) = p(1 − p) ⇒ P(b | ′=0) = P(b
′=1) = 1/2 при любом
p ∈ (0, 1). ■

Скорость: η = p(1 − p) ≤ 1/4 выходных бит на входной; при p = 1/2 ровно 1/4 (потери по скорости ≈ 75%).
Результат на BJT: εˆ: 3,7 · 10−2 → 6,5 · 10−5
(сжатие ∼570×); 13/15 NIST STS.

# Тесты «случайных блужданий»

Рассмотрим частичную сумму:

Sn =

∑n

i=1

(2bi − 1), Sn ∈ Z.

Это симметричное случайное блуждание {Sn} на Z с шагом ±1.

Тесты RandomExcursions и RandomExcursionsVariant проверяют распределение числа посещений состояний k ∈ {−9, . . . , −1, 1, . . . , 9} на одном «цикле» — участке между двумя нулями Sn.

Дефекты после VN:
- крошечное остаточное смещение от нарушенной симметрии P(01)=P(10);
- структурная корреляция между парами.

Оба эффекта искажают длины циклов и распределение посещений ⇒ нужна вторая ступень — декорреляция.

# Постобработка II: XOR-децимация

b

′
j =

⊕n−1

k=0

bnj+k, n = 8.

Основная роль — декорреляция. Усреднение локальных зависимостей внутри окна; соседние выходные биты опираются на непересекающиеся окна ⇒ корреляция между ними падает на порядки.
Дополнительно — устранение остаточного смещения по утверждению об умножении смещений:
P

(⊕n

k=1

bk = 1)
=

1

2 + 2 n−1 ∏n

k=1

εk

n→∞ −−−→ | 1
| 2

Итого каскад: фон Нейман → XOR-децимация (окно 8).

# Главный результат

# NIST STS

15 / 15

## FAIL = 0, N/A = 0

Каскад: фон Нейман → XOR-децимация (окно 8) Hˆ∞ ≈ 0,99980 бит/бит (точечная);
H∞ ≥ 0,99863 бит/бит (MCV, NIST SP 800-90B); пропускная способность ∼ 1,6 кбит/с; выход прозрачен (без криптопримитивов).

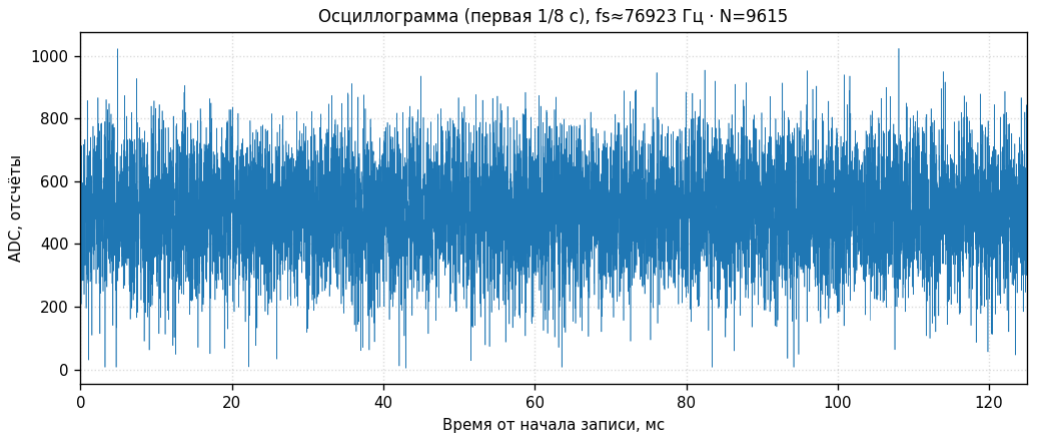
[picture p42: figure]

↓

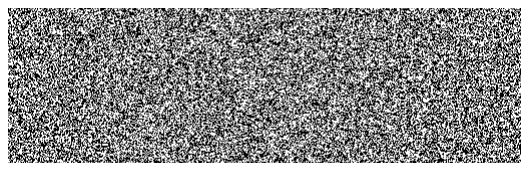
[picture p43: figure]

фрагмент итогового битового потока

# Сравнение источников

Канал | σadc | NIST | H∞ | бит/с
BJT + VN + XOR-Decim | 147 | 15 / 0 | 0,99981 | ∼ 1,6·10³
BJT + VN | 147 | 13 / 2 | 0,99981 | ∼ 1,3·10⁴
Тепловой шум 10 МОм | 15 | 10 / 5 | 0,99923 | ∼ 1,5·10⁴
Микрофон KY-037 | 1 | 4 / 11 | 0,99945 | ∼ 7,5·10³
MPU-6050 | — | 2 / 13 | 0,58478 | ∼ 5,6·10³
Плавающий АЦП | 5 | 0 / 15 | 0,99943 | ∼ 2·10²
Clock jitter | — | 0 / 15 | 0,99966 | ∼ 30

# Выводы

Выполнено:

- теоретический анализ восьми классов физических источников энтропии;
- собран стенд и проведена натурная проверка шести каналов;
- разработаны и обоснованы пять алгоритмов постобработки;
- все каналы оценены по NIST STS, H∞ и скорости генерации.

Главные результаты:

- обоснование каскада: фон Нейман строго устраняет смещение, XOR-децимация экспоненциально подавляет остаток и краткосрочные корреляции;
- на канале BJT с каскадной постобработкой получено 15 / 15 NIST STS без криптопримитивов; стоимость элементной базы < 50 руб.

# Перспективы

## - Встроенный health-мониторинг в реальном времени (тесты SP 800-90B прямо в прошивке) для детектирования

деградации источника на ходу.

## - XOR-смешение нескольких независимых каналов как ещё один уровень — пропускная способность не теряется, H∞

монотонно растёт.

- Перенос каскада постобработок на микроконтроллер.
