60mph/vkr_trng/vkr/presentation/speech.pdf

Слайд 1. Титул (≈ 15 с)

Уважаемые члены комиссии! Меня зовут Шестаков Влад, представляю выпускную квалификационную работу на тему «Разработка концепции физического генератора случайных чисел». Научный руководитель — старший преподаватель Дмитрий Александрович Савинов.

Слайд 2. Актуальность (≈ 45 с)

Случайные числа — основа всей современной криптографии: ключи шифрования, инициализация TLS, мессенджеры, банковские транзакции, IoT-устройства, аппаратные кошельки. Поясню кратко, что это и где именно нужны случайные числа. TLS — протокол защищённого канала (HTTPS, почта, мобильные приложения): при каждом новом соединении клиент и сервер генерируют случайные nonce и эфемерные ключи Диффи–Хеллмана, от качества которых напрямую зависит секретность сессии. Мессенджеры (Signal, WhatsApp, Telegram secret chats) используют end-to-end шифрование, где для каждого сообщения вырабатывается свежий ключ — предсказуемый ГСЧ означает расшифровку всей переписки. Банкинг — генерация одноразовых паролей, токенов сессий, nonce при подписании платежей по ГОСТ Р 34.10 / ECDSA (повтор k в подписи раскрывает приватный ключ). IoT-устройства — ключи привязки, идентификаторы, токены прошивок; типичная проблема — генерация ключа сразу после загрузки, когда энтропийный пул пуст. Аппаратные кошельки (Ledger, Trezor) — генерация seed-фразы BIP-39 (128–256 бит энтропии), от которой производятся все адреса и подписи транзакций. При этом массовые микроконтроллеры не имеют встроенного аппаратного TRNG, а современные рекомендации по генерации ключевого материала — прежде всего NIST SP 800-90B — предполагают использование физических источников энтропии. Дополнительный аргумент в пользу темы — ценность прозрачных постобработок: алгоритмы без секретных ключей и хэш-функций позволяют аудировать сам источник энтропии, тогда как криптографическое отбеливание маскирует его дефекты.

(NIST SP 800-90B регламентирует требования к физическим источникам энтропии: модель IID/non-IID, оценка минимальной энтропии, тесты health на стадии работы. ГОСТ Р 34.10-2012 — стандарт ЭЦП на эллиптических кривых; для каждой подписи требуется одноразовое случайное k ∈ [1, q−1], криптографически качественное. Исторический контекст: дефект Android-генератора 2012 года сделал предсказуемыми ≈ 86% Bitcoin-ключей; атака ROCA (CVE-2017-15361) на библиотеку RSALib Infineon позволила факторизовать ключи миллионов сертифицированных TPM-модулей. Эти инциденты как раз иллюстрируют опасность «непрозрачных» генераторов, выход которых формально проходит тесты, но скрывает уязвимость источника.)

Слайд 3. Цель и задачи (≈ 25 с)

Цель работы — сравнить доступные источники энтропии (аудио-, радио-, фотонные и механические шумы) для проектирования компактного физического генератора случайных чисел с учётом трёх критериев: пакета NIST STS, стоимости и простоты реализации, устойчивости к внешним воздействиям.
Задачи приведены на слайде: теоретический анализ источников и выбор подходящего, сборка стенда на доступной элементной базе, реализация прозрачного конвейера постобработки, и достижение прохождения NIST STS при достаточной для практики скорости генерации.

(Формулировка совпадает с введением ВКР. Под «критериями NIST STS» подразумевается полный набор из 15 групп тестов стандарта SP 800-22 (детально на следующих слайдах). Под «стоимостью и простотой реализации» — цена элементной базы канала и возможность реализовать постобработку без криптографических библиотек. Под «устойчивостью к внешним воздействиям» — зависимость качества выхода от температуры, наводок сети, посторонних акустических/электромагнитных полей.)

Слайд 4. NIST STS: методология проверки (≈ 45 с)

Качество последовательности проверяется статистическими тестами. Нулевая гипотеза H0 формулируется единообразно для всего пакета: «последовательность порождена идеальным источником — независимые биты с вероятностью одной второй». Каждый тест вычисляет некоторую статистику T и её p-значение — вероятность увидеть наблюдаемое или более экстремальное значение при условии истинности H0. Если p-значение меньше порога α = 0,01, гипотеза отвергается и подтест считается провалившимся.
В работе использован пакет NIST STS, стандарт SP 800-22: 15 групп и 188 под-тестов. Проблема множественных сравнений: при 188 под-тестах и α = 0,01 под H0 ожидается порядка двух ложных провалов даже у идеального источника. Поэтому критерий приёмки формулируется в группах — требуется 15/15 PASS, а не «все 188 под-тестов». Это естественный способ учесть проблему множественных сравнений без специальной поправки.

(Случайная величина и последовательность. Случайная величина формально — измеримая функция X : Ω → R, заданная на вероятностном пространстве (Ω, F, P). Случайная последовательность {Xi}
N
i=1 —
набор реализаций случайных величин. Идеальный двоичный поток: Xi ∈ {0, 1}, P(Xi=1) = 1
2

, независимые
в совокупности (для любого конечного подмножества индексов P(

∩

k

{Xk ∈ Bk}) = ∏
k P(Xk ∈ Bk)).

Энтропия Шеннона и минимальная энтропия. H(X) = −

∑

x

px log2

px — средняя информация на символ. H∞(X) = − log2 maxx px — наихудший случай. Для бернуллиевской X с P(X=1) = p: H(X) = −p log2

p − (1 − p)log2

(1 − p), H∞(X) = − log2 max(p, 1 − p). Идеал p = 1/2: H = H∞ = 1 бит/бит. При p = 10−6 Шеннон даёт H ≈ 2 · 10−5
(оптимистично, ведь значение 0 почти гарантировано); H∞ учитывает только наиболее вероятное значение и поэтому подходит для криптогарантий: H∞ = h ⇒ вероятность угадать значение с первой попытки не превышает 2

−h
. Криптография работает именно с H∞, и стандарт NIST SP 800-90B нормирует именно её.

Два класса генераторов. ГПСП (xn+1 = f(xn), при знании семени весь поток воспроизводим): линейный конгруэнтный (Arduino random), Mersenne Twister (Python), криптографические ChaCha20, AES-CTR-DRBG, HMAC-DRBG. ГИСП — Xi из физического процесса, недетерминированного по природе; именно класс ГИСП рассматривается в работе.

Ошибки решения. I рода (отвергнуть истинную H0) — вероятность α; II рода (принять ложную)
— зависит от альтернативы. Выбор α | = | 0,01 — компромисс между мощностью теста и
ложноположительными срабатываниями, рекомендация NIST SP 800-22.)

Слайд 5. NIST STS: классы проверяемых дефектов (≈ 55 с)

Пакет покрывает шесть классов возможных дефектов источника, каждый из которых ловит свой тип зависимости.
Частотные тесты — Frequency, BlockFrequency, CumulativeSums — ищут смещение частоты единиц от одной второй на всём потоке и в блоках, а также аномальный дрейф частичных сумм. Структура серий — Runs и LongestRun — проверяют число пробегов одинаковых битов и самую длинную серию единиц в блоке. Эти тесты ловят краткосрочную корреляцию: если соседние биты слипаются, серий будет аномально мало, а самая длинная — аномально длинная.
Матричная и спектральная — Rank на бинарных матрицах 32 × 32 и FFT — ищут линейную зависимость внутри битовых матриц и периодические пики в спектре, выдающие наводки и сетевые помехи.
Шаблонные — NonOverlapping Template, Overlapping Template и Universal по Маурера — ловят аномальную частоту заданных битовых паттернов и общую сжимаемость потока: настоящий случайный поток несжимаем.
Сложностные — Linear Complexity (длина минимального LFSR через алгоритм Берлекэмпа–

Месси), Approximate Entropy и Serial — проверяют предсказуемость коротких битовых шаблонов, ловят нелинейные и алгоритмические закономерности.
И случайные блуждания — RandomExcursions и RandomExcursionsVariant — аномальную длительность и число визитов частичной суммы Sn =

∑(2bi − 1) в состояния ±k. Подробнее об

этом классе на следующем слайде про постобработку фон Неймана.
Один-два провала, как правило, указывают на конкретный класс дефекта и подсказывают, какую часть конвейера нужно дорабатывать — именно это и произошло в работе при переходе от сырого потока к каскадной постобработке.

(Краткая справка по конкретным статистикам. Frequency: Sn =

∑(2bi − 1), статистика |Sn|/
√
n
— стандартно нормальна под H0. BlockFrequency: χ

2 на pˆ в блоках длины M. Runs: число изменений знака; среднее под H0 — 2npˆ(1 − pˆ). LongestRun: распределение длины максимального пробега единиц в блоке. Rank: распределение ранга матриц 32 × 32, сравнение с теоретическим (формула Колчина). FFT: число гармоник, превосходящих порог T =

√
n ln(1/0,05). Template: число вхождений шаблона W в окнах; распределение пуассоновское. Universal: ожидаемое расстояние между повторениями L-битного шаблона; связано с энтропией. Approximate Entropy: ApEn(m) = ϕ
(m) − ϕ

(m+1), где ϕ

(m) — энтропия m-грамм; в работе под m = 10. Linear Complexity: для блока длины M = 500 строится минимальный LFSR; распределение длины известно. Serial: χ

2 на распределении m-грамм.)

Слайд 6. Архитектура стенда (≈ 35 с)

Архитектурно стенд устроен как конвейер: источник энтропии даёт аналоговый сигнал, усилитель и АЦП формируют поток шестнадцатиразрядных отсчётов, передаваемых по последовательному каналу. На стороне ПК конвейер на Python выполняет захват потока, извлечение младших разрядов, постобработку, анализ — гистограммы, спектральную плотность, автокорреляцию, оценки энтропии, — и запуск NIST STS. Все исследованные источники подключаются к одному и тому же конвейеру через единый бинарный протокол — это делает эксперименты изоморфными между собой.
(Прошивка Arduino Nano (ATmega328P): АЦП в free-running, скорость UART 10⁶ бод (родная для 16 МГц — нулевая ошибка делителя). Эффективная частота отсчётов ≈ 49,6 кГц, упирается в пропускную способность последовательной линии. Конвейер на ПК состоит из модулей capture_serial.py (захват), extract_bits.py (выделение МЗР), пять модулей постобработки в analysis/postprocess_*.py, далее spectral.py, autocorrelation.py, entropy.py, nist_sts/run_sts.sh (обёртка над пакетом NIST STS 2.1.2).)

Слайд 7. Источник энтропии (≈ 25 с)

Источником энтропии служит лавинный пробой обратносмещённого BE-перехода биполярного транзистора BC337. Случайный характер ударной ионизации даёт интенсивный широкополосный шум; сигнал снимается с эмиттера через разделительный конденсатор и подаётся на вход усилителя.

(BC337 включён инвертированно: коллектор и база на землю, эмиттер через балластный Rb = 100 кОм подтянут к +12 В. Лавинный ток ∼ 10 . . . 50 мкА. Разделительный конденсатор C1 = 0,1 мкФ отсекает постоянную составляющую ≈ UBR.

Что такое «случайный характер ударной ионизации». При обратном смещении BE-перехода напряжение UBE ≈ UBR ∼ 9 В создаёт в обеднённой области сильное электрическое поле порядка 10⁵–10⁶ В/см. Свободные носители (электроны и дырки) разгоняются полем, и часть из них набирает кинетическую энергию, превышающую пороговую энергию ионизации Ei ∼ 1,1 эВ для кремния. При столкновении такого «горячего» носителя с атомом решётки происходит ударная ионизация — выбивается новая электрон-дырочная пара, которая, в свою очередь, разгоняется полем и может породить следующую пару (лавинное умножение).

Случайность возникает в трёх местах сразу:

- Момент ионизации. Длина свободного пробега носителя между столкновениями — случайная величина (распределение Пуассона по числу актов в единицу времени, экспоненциальное по времени между ними).
- Координата ионизации. Где именно в обеднённой области произошёл акт — зависит от микроскопических флуктуаций положения и скорости носителя.
- Размножение в лавине. Сколько потомков породит данный акт — случайная величина (ветвящийся процесс Гальтона–Уотсона), описываемая коэффициентами ионизации αn(E), αp(E) для электронов и дырок. Этот «множительный» эффект и даёт интенсивный шум: флуктуация одного акта в начале лавины умножается на коэффициент умножения M ∼10–100.

В сумме ток через переход — это пуассоновский поток актов с интенсивностью λ ∼ 10¹⁰–10¹² событий в секунду (оценка из I ≈ eMλ); по теореме Кэмпбелла дисперсия тока пропорциональна λ, спектральная плотность SI (f) практически плоская до полосы ∼ ГГц («белый» шум на наших масштабах ≤ 50 кГц). Это и есть тот самый «интенсивный широкополосный шум», который мы снимаем с эмиттера.

Энтропийная интерпретация. Каждый акт ударной ионизации — независимое микроскопическое событие, исход которого фундаментально непредсказуем (квантовомеханическая вероятность столкновения). За время одного отсчёта АЦП (∆t = 20 мкс) происходит порядка 10⁵–10⁷ актов, и итоговый ток — это сумма большого числа независимых случайных вкладов. Отсюда и работает ЦПТ (см. слайд 9): форма распределения тока приближённо нормальна, а младший разряд оцифровки несёт практически чистую энтропию «квантовых рулеток» внутри полупроводника.)

Слайд 8. Аналоговый усилительный тракт (≈ 15 с)

На слайде представлена принципиальная схема двухкаскадного неинвертирующего усилителя на сдвоенном ОУ LM358 с коэффициентом порядка пятисот; оцифровка выполняется десятиразрядным АЦП Arduino Nano.

(Каждый каскад — типовое включение 1 + Rf /Rg. Первый каскад: Rg = 10 к, Rf = 470 к, G1 ≈ 48. Второй: Rg = 10 к, Rf = 100 к, G2 ≈ 11. Итог: G ≈ 528. Однополярное питание +12 В; опорное напряжение Vmid задаётся отдельным делителем от шины +5 В Arduino. Каскады соединены резистивной связью без разделительного конденсатора — сохраняем низкочастотные компоненты.)

Слайд 9. Распределение сырого сигнала (≈ 40 с)

На слайде приведена гистограмма отсчётов АЦП канала BJT. Параметры выборки и оценки среднего и стандартного отклонения — на слайде. Огибающая распределения хорошо аппроксимируется нормальной — это согласуется с центральной предельной теоремой.
Важная деталь: внутри огибающей чётко видна «гребёнка» — неравномерность частот соседних кодов АЦП. Критерий Пирсона на согласие с идеальной нормальной плотностью даёт огромную статистику хи-квадрат и p-значение практически равное нулю — формально распределение строго отличается от нормального. Это типичное проявление нелинейности АЦП (DNL/INL): некоторые коды появляются чаще соседних, отсюда «зубцы».
Битовый поток получаем извлечением младшего разряда. Подчёркну: огибающая описывает крупномасштабную форму распределения, а распределение младших разрядов зависит от мельчайших бин-уровневых деталей — это совершенно разные характеристики. Форма огибающей сама по себе ничего не говорит о распределении младших разрядов; их надо проверять отдельно.

(Обозначения на слайде. Yi ∈ {0, . . . , 1023} — i-й отсчёт АЦП (10 разрядов ⇒ 2

10 = 1024 возможных
значения), i = 1, . . . , N, N ≈ 85·10⁶
; bi = lsb(Yi) — младший двоичный разряд отсчёта (битовый поток); µˆ — выборочное среднее, σˆ — выборочное стандартное отклонение; χ

2 — статистика критерия Пирсона;

p — p-значение этого критерия; DNL/INL — дифференциальная и интегральная нелинейность АЦП (см. ниже).
Центральная предельная теорема (ЦПТ). Пусть ξ1, ξ2, . . . , ξn — независимые одинаково распределённые случайные величины с Eξk = µ и 0 < Dξk = σ
2 < ∞. Тогда нормированная сумма сходится по распределению к стандартной нормальной:

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
(ξk − µ)

d−→ N (0, 1).

Как применяется у нас (тезисно):

- ξk — вклады отдельных актов ударной ионизации в лавинный ток BJT; число актов в окне выборки АЦП велико.
- Усилительный тракт линеен ⇒ напряжение на выходе ОУ — линейная комбинация этих вкладов, нормальность «наследуется».
- Отсюда характерный «колокол» на гистограмме с µˆ≈505, σˆ ≈147.

Выборочные оценки: µˆ =

1
N

∑N
i=1 Yi

, σˆ

2 =

1
N−1

∑N
i=1(Yi − µˆ)

2
(оценка дисперсии с поправкой Бесселя, делитель N − 1).

Критерий согласия Пирсона (χ

2
). Проверяемая гипотеза H0: «Yi ∼ N (ˆµ, σˆ

2
)». Шкалу значений
{0, . . . , 1023} разбиваем на K = 1024 корзины (по одному коду АЦП на корзину); пусть Ok — наблюдённая частота попадания в k-ю корзину (∑
k Ok = N), Ek = N·pk — ожидаемая при H0, где pk — теоретическая вероятность попадания в k-ю корзину (по нормальной плотности с параметрами µ, ˆ σˆ). Статистика:

χ

2 =

∑

K

k=1

(Ok − Ek)

2

Ek

При истинной H0 эта статистика асимптотически распределена как χ

2
с K − 1 − r степенями свободы, где r — число оценённых из данных параметров (r = 2 для µˆ и σˆ), то есть у нас df = K − 3 = 1021. Свойства: Eχ
2

df = df, Dχ
2
df = 2 df. Значит, под H0 типичное значение статистики около 1021, и почти все реализации лежат ниже 1100.
p-значение — вероятность увидеть значение статистики не меньше наблюдаемого при условии H0: p =
P(χ
2
df ≥ χ

2
набл | H0). Правило решения: p < α (α = 0,01) ⇒ отвергнуть H0.

Что значит «более экстремальное». Это значение статистики, которое сильнее свидетельствует против H0, чем наблюдаемое. Направление зависит от теста:

- Правосторонний (χ

2
, F): экстремальнее = больше, так как при H0 статистика концентрируется около df, а большие значения говорят о расхождении с моделью.
- Левосторонний: экстремальнее = меньше.
- Двусторонний (z, t при H0 : µ = µ0): экстремальнее = дальше от 0 по модулю: |T| ≥ |tнабл|.

Почему «не меньше», а не «равно»: для непрерывной статистики P(T = t) = 0 для любого точечного t, поэтому смотрим на хвост — диапазон значений как минимум столь же красноречивых против H0.

Главное недоразумение: p ≈ 0 не значит, что значение увидеть невозможно. p-value — это контрфактическая вероятность: «если бы H0 была верна, насколько вероятно было бы получить такое наблюдение». Слова «если бы» здесь критичны: мы не утверждаем заранее, что H0 верна, мы лишь считаем, что было бы в этом гипотетическом мире.
Если p≈0, это значит: в мире, где H0 верна, такое наблюдение почти невозможно. Но мы его уже видим в реальных данных — факт никуда не делся. Логика: «из H0 следует, что такого не увидим; мы увидели; значит H0 ложна». Это и есть аргумент опровержения.

Аналогия с алиби. Подозреваемый говорит: «Я был дома один» (H0). Свидетель видел его на месте преступления. Под H0 такого свидетеля быть не должно — вероятность ≈ 0. Но свидетель есть. Неправильный вывод: «значит, свидетеля не существует». Правильный: «значит, алиби ложно, H0 отвергаем».
Геометрически. На графике плотности χ

2
df под H0: типичные значения вокруг df = 1021, хвост быстро убывает вправо. Наблюдённое χ

2

набл = 1,17·10⁸
лежит невообразимо далеко в правом хвосте; p-value — площадь хвоста правее наблюдения; эта площадь ниже точности float64 (∼10−308), отсюда вывод «p =

0,000e+00».
Важная оговорка. p ≈ 0 не означает «доказали ложность H0 с вероятностью 1». Это очень сильное статистическое свидетельство против H0. Технически остаётся ничтожный шанс (∼ e

−χ

2/2) очень
неудачной выборки — но он порядка 10−10⁷
, что практически и есть ноль.

Что значит «χ

2 ≈1,17 · 10⁸

, p≈0» у нас. Наблюдённая статистика в ∼ 10⁵ раз превосходит ожидаемое значение df = 1021. Вероятность увидеть такой χ

2 под H0 ничтожно мала (порядка exp(−χ

2/2), что
вычислитель округляет до нуля). Следовательно, H0 строго отвергается: распределение Yi не является в точности нормальным.
Причины отклонения от нормальности. (а) Квантование: непрерывный сигнал V (t) принимает дискретные значения Yi ∈ {0, . . . , 1023}, что само по себе не идёт вразрез с нормальностью при малом шаге, но в сочетании с (б) даёт «зубцы». (б) Дифференциальная нелинейность (DNL, Differential Non-Linearity): отличие реальной ширины ступеньки передаточной характеристики k-го кода от идеального 1 LSB. Если Wk = LSB + δk, то pk ∝ Wk, и коды с большим Wk заполняются чаще, образуя «зубцы». (в) Интегральная нелинейность (INL, Integral Non-Linearity): отклонение всей передаточной характеристики от прямой — интегральная сумма всех δk. Создаёт медленную модуляцию плотности поверх «зубцов». Для нашей задачи (генерация случайных чисел) это не дефект источника энтропии, а свойство преобразователя. Важна не идеальная нормальность Yi

, а равномерность bi = lsb(Yi) после постобработки — её и проверяем по NIST STS.
МЗР гауссовой величины. Если Y ∼ N (µ, σ²

) и квантование с шагом ∆, то P(lsb(Y ) = 1) → 1/2 при σ/∆ → ∞, с остаточным смещением порядка e

−2π

2σ

2/∆²
cos(2πµ/∆). На канале BJT σadc ≈ 147, ∆=1 даёт остаточное смещение ∼ 10−4
, что согласуется с эмпирикой.)

Слайд 10. Сырой битовый поток: что мы видим (≈ 40 с)

Эмпирически у сырого битового потока доминирующий дефект — смещение: эмпирическая вероятность единицы отличается от одной второй ощутимо (точное значение приведено на слайде; виновата гребёнка гистограммы). На приведённой АКФ битового потока доля точек вне доверительного интервала практически совпадает с теоретическими пятью процентами под нулевой гипотезой «белый шум». То есть на бит-уровне поток уже можно считать практически белым шумом: глобальной структурной корреляции не видно. Корреляция мала, но может быть значима на отдельных малых лагах — остаточный след ограниченной полосы тракта; именно его и доберёт XOR-децимация во второй ступени каскада.
Формально задача постобработки — найти функцию из множества двоичных строк длины n в множество длины m (не превышающей n), такую что смещение на выходе стремится к нулю и корреляция тоже к нулю. В работе рассмотрено пять таких функций, основная — корректор фон Неймана, итоговая каскадная — фон Нейман с последующей XOR-децимацией.
(Эмпирическая оценка смещения: εˆ = ˆp1 − 1/2, где pˆ1 =

1
n

∑bi — частота единиц. Закон больших чисел

даёт pˆ1

p
−→ P(bi=1); при n = 10⁸ и доверительной вероятности 99% ширина доверительного интервала ≈ 2,58√
p(1 − p)/n ≈ 10−4
. Эмпирическая автокорреляция ρˆ(k) = 1
| n−k

∑
| i (bi−pˆ)(bi+k−pˆ)/ˆσ
| 2 ; для сырого
МЗР канала BJT |ρˆ(1)| ∼ 10−3 ÷ 10−2

Как вообще считается корреляция, простыми словами. Корреляция — это число от −1 до +1, измеряющее силу линейной связи между двумя величинами. Идея в три шага.

Шаг 1. Ковариация. Берём две величины X, Y с математическими ожиданиями µX, µY и для каждой пары наблюдений считаем отклонения от средних: (Xi − µX) и (Yi − µY ). Смотрим на произведение этих отклонений. Если оба отклонения положительны или оба отрицательны, произведение > 0 (величины «движутся вместе»); если разных знаков — < 0 (одна растёт, другая падает); если связи нет — произведения хаотично прыгают вокруг нуля и в среднем сокращаются. Среднее этих произведений и есть ковариация: cov(X, Y ) = E[(X − µX)(Y − µY )].

Шаг 2. Нормировка. Проблема ковариации — её величина зависит от единиц измерения. Чтобы получить безразмерное число, делим на произведение среднеквадратичных отклонений: ρ(X, Y ) = cov(X, Y )/(σXσY ). Результат всегда в [−1, +1]: +1 — идеальная прямая связь (Y = aX + b, a > 0); −1 — идеальная обратная; 0 — линейной связи нет.
Шаг 3. Автокорреляция = корреляция ряда с самим собой. Когда у нас не две разные величины, а временной ряд X1, . . . , Xn, спрашиваем: насколько Xi связан с Xi+k, отстоящим на k шагов? Берём ряд X и его сдвинутую копию X+k — и считаем для них обычную корреляцию. Это и есть АКФ на лаге k: ρˆ(k) =

1
n−k

∑

i

(Xi − X¯)(Xi+k − X¯)/ˆσ
2
Пример. Последовательность 1, 0, 1, 0, 1, 0, 1, 0 имеет ¯b = 0,5, отклонения ±0,5. На лаге 1 соседние биты всегда разного знака ⇒ произведения всегда −0,25 ⇒ ρ(1) = −1 (максимальная антикорреляция). На лаге 2 биты через один одинаковы ⇒ ρ(2) = +1. Для белого шума знаки произведений случайны и в среднем сокращаются ⇒ ρ(k) ≈ 0 при k ̸= 0.
Как читать график АКФ. По оси X — лаг k, по оси Y — значение ρ(k). Под H0 «белый шум» все ρ(k) при k ≥ 1 должны лежать в полосе ±1,96/√
n (95 % ДИ по формуле Бартлетта). Доля точек за пределами этой полосы ∼ 5 % — норма (false-positive по выбору α = 0,05), существенно больше — корреляция статистически значима.

По картинке АКФ битового потока. Под нулевой гипотезой H0: «биты i.i.d. (белый шум)» оценки автокорреляции ρˆ(k) на лагах k ≥ 1 по формуле Бартлетта асимптотически нормальны со средним 0 и дисперсией 1/n. Соответствующий 95 % доверительный интервал — ±1,96/√
n (на графике показан
горизонтальными линиями). По определению 95 % ДИ при выполнении H0 за его пределы должно случайно «вылетать» в среднем ровно 5 % лагов (это false-positive rate, обусловленный самим выбором уровня значимости α = 0,05).
Эмпирически получено 4,9 % точек вне ДИ — практически совпадает с ожидаемыми 5 % под H0. То есть на бит-уровне сырого канала H0 о белом шуме не отвергается: МЗР сильно зашумлён квантованием АЦП, и почти вся корреляция аналогового тракта (RC-завал на ∼ 50 кГц) теряется при извлечении младшего разряда.

Замечание: на уровне отсчётов АЦП (Yi ∈ {0, . . . , 1023}) та же АКФ даёт порядка 7 % точек вне ДИ — то есть на полном разрядном уровне корреляция тракта статистически значима. Однако в практической постобработке работаем именно с битами, и доминирующим дефектом остаётся смещение εˆ ≈ 3,7·10−2 — именно оно валит NIST STS на сыром потоке (через накопление в случайных блужданиях). Остаточная корреляция битов мала (|ρˆ(1)| ∼ 10−4
), но может быть значима на отдельных малых лагах — этот «хвост» и убирает XOR-децимация.

Почему ограниченная полоса тракта вызывает автокорреляцию. Идеальный физический источник энтропии порождает белый шум — сигнал с плоским спектром на всех частотах. Для белого шума автокорреляция ρ(τ ) = 0 при любом τ ̸= 0, то есть отсчёты независимы. Реальный аналоговый тракт (усилитель LM358 + обвязочные RC-цепи + АЦП) ведёт себя как ФНЧ с частотой среза fc ∼ 50 кГц — сигнал выше fc режется. Связь спектра и АКФ дана теоремой Винера–Хинчина: ρ(τ ) = F

−1{S(f)}.
Если спектр не плоский (а урезан фильтром), его обратное преобразование Фурье — не дельта-функция: для RC-фильтра первого порядка ρ(τ ) ∝ e

−2πfc|τ|
, то есть автокорреляция экспоненциально затухает с характерным временем τc = 1/(2πfc).

Физический смысл: RC-цепь — это инерция, конденсатор не может мгновенно изменить заряд, поэтому выход «помнит» предыдущее значение в течение τc. Соседние отсчёты АЦП, взятые через ∆t < τc, унаследуют часть предыдущего значения — отсюда и ρ(Yi

, Yi+1) ̸= 0.

Численная оценка для стенда: fc ≈ 50 кГц ⇒ τc ≈ 3,2 мкс; АЦП работает с шагом ∆t ≈ 20 мкс — это ≈ 6τc, и теоретическая ρ(1) ∝ e

−6 ≈ 2,5 · 10−3

хорошо согласуется с эмпирическим |ρˆ(1)| ∼ 10−4 на битах. Эффект универсален: не зависит от типа источника шума — любой физический усилитель неизбежно ограничен по полосе, и это всегда оставляет след в автокорреляции.

Реально измеренное смещение на разных этапах конвейера BJT. Прямой подсчёт частоты единиц на выходных файлах постобработки:

Этап | n бит | pˆ1 | εˆ | Hˆ∞ | HMCV ∞
Сырой LSB | 8,5·10⁷ | 0,46313 | 3,69·10−2 | 0,9479 | —
После vN | 2,54·10⁸ | 0,50006 | 6,5·10−5 | 0,99981 | 0,99958
vN + XOR-8 | 10⁷ | 0,49993 | 6,76·10−5 | 0,99980 | 0,99863

Что важно из этой таблицы.
Сырое смещение — около 3,7 % — неожиданно большое. Причина не в источнике энтропии (лавинный шум сам по себе симметричен), а в нелинейности АЦП: «гребёнка» гистограммы (DNL/INL) делает чётные коды АЦП чуть более вероятными, чем нечётные, отсюда сдвиг в LSB. Этот же эффект подсвечивает критерий Пирсона на слайде 9 (p≈0 для нормальности).
vN сжал смещение в ∼ 570 раз (с 3,7 % до 6,5 · 10−5
). Это очень эффективная компрессия. Если бы пары на входе vN были строго независимы, остаточное εˆ должно было бы быть равно нулю на популяции; наблюдаемое 6,5 · 10−5 при стандартной ошибке σpˆ =

√
p(1 − p)/n ≈ 3 · 10−5 — отклонение всего ∼ 2σ, на грани измерения. То есть в реальности vN работает почти как в идеальной модели: входная корреляция настолько мала, что её влияние на остаточное смещение неизмеримо.
XOR-8 на выходе εˆ практически не меняет (6,5 · 10−5 → 6,76 · 10−5
). Теоретическая оценка по лемме об умножении смещений εвых = 2⁷
- (6,5 · 10−5
)

8 ∼ 10−30 говорит, что истинное смещение на выходе — неизмеримо мало; наблюдаемые 6,76 · 10−5 — это шум статистической оценки при n = 10⁷
, а не
реальное смещение источника. Соответственно, точечная Hˆ∞ и MCV-оценка фактически отражают предел измерения, а не качество источника.
Бит-уровень ρˆ(1) после vN. На длинной выборке (n = 2,54 · 10⁸

) измеренное ρˆ(1) ≈ −1,4 · 10−4 ,
что соответствует ∼ 2,2σ от нуля — слабо значимо. То есть структура от полосы тракта всё же просочилась в выход vN, но величина её крайне мала. Именно эту крошку и должен подобрать XOR.

Главный вывод. Конвейер vN + XOR-децимация на канале BJT не просто проходит NIST STS, а делает это с запасом: реальные дефекты после каскада ниже статистического разрешения измерения. Цифра HMCV
∞ =
0,99863 — консервативная нижняя оценка с уровнем доверия 99 %; истинная min-entropy практически равна 1.)

Слайд 11. Корректор фон Неймана (≈ 60 с)

Алгоритм фон Неймана: разбиваем биты на пары и применяем правило — пара (0, 1) даёт выходной бит ноль, пара (1, 0) — единицу, одинаковые пары (0, 0) и (1, 1) отбрасываются. Идеальное утверждение: если входные биты независимы и имеют любую вероятность p, выход строго несмещён. Доказательство одностраничное: вероятности противоположных пар равны p умножить на 1 − p, то есть равны между собой, следовательно вероятность выходного нуля равна вероятности выходной единицы и равна одной второй, независимо от исходного p.
Важная оговорка: условие независимости здесь критично. В реальной последовательности с канала BJT пары на входе слабо коррелированы из-за ограниченной полосы аналогового тракта, симметрия вероятностей пар нарушается, и vN даёт не строго несмещённый выход, а почти несмещённый с остаточной структурной корреляцией.
Скорость на выходе: при идеальном входе один выходной бит приходится в среднем на четыре входных, то есть потери по скорости порядка семидесяти пяти процентов. Точная формула приведена на слайде.

На канале BJT после фон Неймана получено тринадцать PASS из пятнадцати групп NIST STS. Проваливаются только тесты случайных блужданий — RandomExcursions и RandomExcursionsVariant, и причина именно в остаточной корреляции, которую vN в принципе не устраняет.

(Подробное доказательство несмещённости. Пусть входные биты b1, b2, . . . независимы и одинаково распределены с P(bi = 1) = p, P(bi = 0) = 1 − p, где p ∈ (0, 1) произвольно. Группируем биты в пары

(b2i−1, b2i).

Вычислим вероятности четырёх возможных пар (по независимости вероятность пары равна произведению вероятностей):

- P((0, 0)) = (1 − p)(1 − p) = (1 − p)
2
,
- P((0, 1)) = (1 − p) · p = p(1 − p),
- P((1, 0)) = p · (1 − p) = p(1 − p),
- P((1, 1)) = p · p = p
2

Ключевое наблюдение: P((0, 1)) = P((1, 0)) = p(1 − p) — эти две вероятности равны при любом p, просто потому что в произведении p ·(1 − p) множители можно переставить. Именно эта симметрия и используется в алгоритме.
Применяем правило фон Неймана: пары (0, 0) и (1, 1) отбрасываем, (0, 1) → b

′ = 0, (1, 0) → b

′ = 1.
Условная вероятность того, что пара выжила (т. е. она смешанная):
P

(
пара ∈ {(0, 1),(1, 0)}

)
= 2p(1 − p).

Тогда условные вероятности выходного бита:

P(b

′ = 0 | пара выжила) = P((0, 1))
2p(1 − p)

=

p(1 − p)
2p(1 − p)

=

1/2,

P(b

′ = 1 | пара выжила) = P((1, 0))
2p(1 − p)

=

1/2.

Получили P(b

′ = 0) = P(b

′ = 1) = 1/2 при любом p ∈ (0, 1). Смещение полностью убрано, и это не зависит от того, насколько сильно p отклоняется от 1/2. □

Интуиция. Смещение — это асимметрия (единиц или нулей больше). Когда мы оставляем только смешанные пары (одна 0 и одна 1), у нас по построению ровно одно из двух значений каждого типа — асимметрия «вырезана». Порядок «сначала 0, потом 1» против «сначала 1, потом 0» симметричен по независимости битов в паре, и этой симметрии достаточно для несмещённости выхода.

Скорость / потери по скорости. Вероятность выживания пары: P((0, 1) ∪ (1, 0)) = 2p(1 − p) ≤ 1/2 — максимум половина пар выживает (при p = 1/2). Каждая выжившая пара даёт один выходной бит, но содержит два входных, поэтому скорость на выходе

ηout =

1/2· 2p(1 − p) = p(1 − p) ≤ 1/4

выходных бит на один входной. При p = 1/2 ровно 1/4 — то есть в идеале один выходной бит на каждые четыре входных, а потери по скорости составляют 1 − 1/4 = 3/4, или 75 %. Это «плата» за гарантированную несмещённость.
Не путать с информационным пределом: оптимальный экстрактор может извлечь до H(p) = −p log2

p−
(1 − p)log2

(1 − p) бит на входной бит (энтропия Шеннона). При p = 1/2 это 1 бит/бит. vN даёт 1/4 — то есть лишь 25 % от теоретического оптимума. Это «цена прозрачности»: vN ничего не предполагает о структуре источника, кроме независимости пар, поэтому сильно теряет в пропускной способности по сравнению с криптоэкстракторами.

Условие независимости критично. Доказательство опирается на P((b2i−1, b2i) = (x, y)) = P(b2i−1 =
x) · P(b2i = y). Если есть корреляция между битами в паре, равенство P((0, 1)) = P((1, 0)) нарушается, и выход получает остаточное смещение. Именно поэтому фон Нейман на сыром потоке BJT (где есть остаточная корреляция от полосы тракта) не даёт идеального результата и проваливает тесты случайных блужданий.

Историческая заметка. Алгоритм предложен Джоном фон Нейманом в работе 1951 года «Various Techniques Used in Connection With Random Digits». Работает за один проход с константной памятью — реализация ∼ 5 строк на любом языке.)

Слайд 12. Тесты случайных блужданий (≈ 55 с)

Рассмотрим частичную сумму с шагами плюс-минус один: каждый бит ноль даёт шаг минус один, бит единица — шаг плюс один. Это симметричное случайное блуждание на целочисленной оси. Тест RandomExcursions проверяет распределение числа посещений состояний от минус девяти до плюс девяти за один цикл — участок между двумя нулями последовательности частичных сумм. Для идеального источника распределение числа посещений описывается явной формулой. Почему vN не вытягивает эти тесты: его доказательство несмещённости работает только при независимости пар. На реальных данных пары слабо коррелированы, и vN оставляет два эффекта: крошечное остаточное смещение от нарушенной симметрии вероятностей пар и структурную корреляцию между парами, которую vN в принципе не трогает. Оба эффекта искажают длины циклов случайного блуждания: средние длины и распределения числа посещений отличаются от теоретических, и p-value падает ниже порога альфа. Нужна вторая ступень, которая бы именно декоррелировала поток.

(Формально частичная сумма Sn =

∑n
i=1(2bi − 1) образует рекуррентное марковское блуждание на Z. Состояние k ̸= 0 визитом в цикле называется попадание блуждания в k между моментами τj , когда Sτj = 0. Для идеального симметричного блуждания ожидаемое число посещений состояния k за один цикл известно явно (уравнение Лоэва), и тестовая статистика χ
| 2 сравнивает наблюдаемое распределение
с теоретическим по |k| = 1, . . . , 9. Малейшее изменение вероятности P(bi = 1 | bi−1, bi−2, . . .) от
безусловной 1/2 приводит к сдвигу распределения длин циклов: они становятся короче (положительная корреляция между шагами) или длиннее. На канале BJT после VN при n = 10⁷ оба теста — основной и variant — дают p → 0, провал устойчиво воспроизводится.)

Слайд 13. XOR-децимация: умножение смещений (≈ 55 с)

Алгоритм XOR-децимации: выходной бит равен побитовой сумме исключающего ИЛИ из n подряд входных бит, где n равно восьми.
Основная роль XOR в нашем каскаде — декорреляция. Если корреляция входа имеет конечный масштаб L, то есть ρ(k) → 0 при k > L, и n > L, то XOR объединяет несколько слабо зависимых битов в один выходной, усредняя влияние локальных корреляций внутри окна. При этом соседние выходные биты строятся из непересекающихся окон — они отстоят друг от друга на ≥ n входных бит, поэтому корреляция между выходными битами падает на порядки. Это именно то, чего не хватало после фон Неймана.
Вспомогательная роль — устранение остаточного смещения по утверждению об умножении смещений (piling-up lemma): смещение выходного бита выражается через произведение входных смещений с экспоненциально растущим множителем по n. Формула приведена на слайде. Поскольку входные смещения малы и меньше одной второй, выходное смещение убывает геометрически с ростом окна — крошечный остаток после фон Неймана превращается в неизмеримо малую величину. Это страховка от неидеальности первой ступени.
В итоговом каскаде vN снимает основную долю смещения, XOR убирает остаточную корреляцию и страхует от неидеальности vN. Случайные блуждания становятся неотличимы от теоретических, и все пятнадцать групп NIST STS проходят.
(Доказательство утверждения по индукции: для двух бит P(b1 ⊕ b2 = 1) = p1(1 − p2) + (1 − p1)p2 =

1
2 + 2ε1ε2. Индуктивный шаг: добавление третьего бита даёт коэффициент 2, в общем случае 2

n−1 ∏
εk.
Это позволяет оценить, какое смещение терпит каскад: при ε ≤ 10−3 и n = 8 выходное смещение не превышает 2

7

- 10−24 ∼ 10−21 — ниже статистической различимости при любом разумном объёме выборки. Эффект декорреляции: если корреляция входных бит имеет масштаб L (например, ρ(bi

, bi+k) ∝
e

−k/L), то после блочной XOR-децимации на окне n > L корреляция выхода падает на порядки. Сжатие: n входных бит дают 1 выходной, η = 1/n = 1/8. В каскаде с фон Нейманом совокупное сжатие ∼ 1/32 от исходных ∼ 50 тыс. бит/с, итог ∼ 1,6 кбит/с.

Почему «экспоненциальное убывание» — это корректно. При εk = ε модуль остаточного смещения
|εвых| = 2n−1
|ε|

n =
1/2(2|ε|)

n =
1/2 r

n
, где r = 2|ε|. Это форма C·r

n
с r < 1 — классическое экспоненциальное (геометрическое) убывание по n.
Условие: |2ε| < 1, т. е. |ε| < 1/2. У нас |ε| ∼ 10−4 ≪ 1/2, условие выполнено с гигантским запасом. Численно у нас. r = 2ε ≈ 1,3 · 10−4
, при n = 8 |εвых| ≈ 1
2

(1,3 · 10−4
)

8 ≈ 4 · 10−32 — даже не «просто экспоненциально», а сверхбыстро (показатель r сам очень мал).
Альтернативные формулировки, тоже корректные: «геометрической прогрессией», «как r

n»,
«суперэкспоненциально при малом ε». Что НЕ корректно: «полиномиально» или «линейно» — там зависимость другая.

Оговорка. Лемма требует независимости входных битов. Это обсуждается на слайдах 11–12: при коррелированном входе формула даёт лишь верхнюю оценку, но порядок убывания остаётся тем же.)

Слайд 14. Главный результат (≈ 40 с)

Главный результат: на канале BJT после каскада фон Нейман в композиции с XOR-децимацией с окном восемь получено пятнадцать PASS из пятнадцати групп NIST STS, без провалов и неприменимых тестов. Точечная и MCV-оценки минимальной энтропии приведены на слайде; на практике это означает, что истинное смещение источника лежит ниже погрешности измерения. Скорость генерации — порядка полутора килобит в секунду. Выход прозрачен — получен без криптографических примитивов, только за счёт двух последовательно применённых линейных преобразований. На правой части слайда сверху приведена осциллограмма сырого сигнала,
стрелка вниз символизирует весь конвейер, и внизу — фрагмент итогового битового потока в виде монохромного растра.

(Конкретные значения на итоговом потоке после vN + XOR-децимации (файл postproc_decim_xor8win_vn2.bin, n = 10⁷ бит): единиц 4 999 324, нулей 5 000 676, pˆ1 = 0,4999324, pˆmax = 0,5000676, эмпирическое смещение
εˆ = 6,76 · 10−5

. Точечная min-entropy Hˆ∞ = − log2 pˆmax = 0,99980 бит/бит. Энтропия Шеннона ≈ 0,99999999.

Что такое MCV-оценка. Most Common Value estimator (NIST SP 800-90B, Section 6.3.1) — консервативная нижняя оценка минимальной энтропии. Идея: точечная Hˆ∞ = − log2
pˆmax зависит от случайной выборки и при малом n может оказаться завышенной (мы могли просто не наблюдать наиболее вероятное значение достаточно часто). MCV берёт верхнюю границу 99 % доверительного интервала на pˆmax:

pu = ˆpmax + z0,99 ·

√
pˆmax(1 − pˆmax)/n, z0,99 = 2,576,

и считает HMCV
∞ = − log2
pu. Это значение — нижняя оценка истинной min-entropy при уровне доверия 99 %: с вероятностью не менее 99 % настоящая H∞ источника не хуже выданной оценки. Для итогового потока: pu = 0,5004749, что даёт

HMCV
∞ = − log2

(0,5004749) ≈ 0,99863 бит/бит.

Иными словами: с вероятностью ≥ 99 % настоящая min-entropy выходного потока не ниже 0,99863 бит на бит — это и есть консервативная криптографическая гарантия, на которую опирается NIST SP 800-90B при сертификации источников энтропии. На практике: для извлечения k бит ключевого материала нужно прокачать через каскад порядка k/HMCV
∞ бит источника (с небольшим запасом).

Почему точечная и MCV оценки так близки к 1. Теоретически по лемме об умножении смещений, если вход в XOR-децимацию имел ε ∼ 6,5 · 10−5
(после vN), выход даёт εвых ∼ 2

n−1
ε

n = 2⁷

- (6,5 · 10−5
)

8 ∼
10−31 — практически идеальный H∞ → 1. Но измерить такой ε невозможно: при n = 10⁷ стандартная
ошибка σ(ˆp) = √
p(1 − p)/n ≈ 1,58 · 10−4

, и наблюдаемое εˆ = 6,76 · 10−5 — это меньше половины σ, т. е. статистически неотличимо от нуля. Цифры 0,99980 / 0,99863 отражают погрешность измерения, а не реальное смещение источника.

Прочие замечания. На картинке справа — осциллограмма сырого сигнала (fs ≈ 77 кГц, ∼ 9600 отсчётов за 125 мс), стрелка вниз символизирует весь конвейер (LSB → vN → XOR-децимация), внизу — визуализация фрагмента 512 × 512 итогового битового потока в виде монохромного растра. Все 188 подтестов NIST STS дают p-value выше 0,01; распределение p-value по 10 потокам формы 10⁶ бит каждый равномерно на отрезке [0, 1], что подтверждает корректность всей цепочки.

Сравнение всех пяти постобработок (поверх vN) на канале BJT. В работе протестировано пять различных способов второй ступени каскада. Сводные результаты по группам NIST STS:

Метод | Описание | NIST
xor_delay8 | ′ b i = bi⊕bi−8 — XOR с задержкой; сохраняет длину потока, декоррелирует только по сдвигу 8 | 13/15
xor_lsb012 | Скользящий XOR трёх подряд бит: b ′ i = bi ⊕ bi+1 ⊕ bi+2 | 13/15
decim_xor8win | Выбранный. XOR-децимация: один выходной бит — XOR из 8 подряд входных, окна без перекрытия. Сжатие 1:8 | 15/15
fold_lsb_byte | Побайтовое XOR-shift отбеливание: каждый байт «сворачивается» операциями сдвига и XOR в один бит | 15/15
sha256_2048 | SHA-256 от блоков по 2048 байт. Криптографический хэш — непрозрачное отбеливание, оставлено для сравнения | N/A

Почему отброшены ‘xor_delay8‘ и ‘xor_lsb012‘: оба сохраняют длину потока (нет децимации) и не разрушают длинных корреляций — проваливают RandomExcursions и RandomExcursionsVariant. Накопление в случайных блужданиях «видит» остаточную структуру.
Почему выбран именно ‘decim_xor8win‘ (а не ‘fold_lsb_byte‘): оба дают 15/15, но decim_xor8win проще в реализации (одна строка кода вместо побайтовых сдвигов), допускает аналитический расчёт смещения и корреляции (через лемму об умножении смещений), легче переносится на микроконтроллер. fold_lsb_byte — это, по сути, частный вариант XOR-децимации на байтовых границах.
Почему SHA-256 не учитывался: (а) выход ≈ 0,495 МБ короче минимума 1,25 МБ для NIST STS при streams=10, n=10⁶
; (б) криптографический хэш маскирует дефекты источника, а не устраняет их — такой выход непрозрачен для аудита и нарушает заявленный принцип «постобработка без криптопримитивов». SHA-256 оставлен как контрольная точка для сравнения, но в продакшен-конвейер
не идёт.

Историческая ссылка: полная таблица с p-value по всем 188 подтестам для каждого метода — в файле
trng/data/reports/ 03_bjt_avalanche_vcc_stabilization_aftervn_exp/postprocessing_nist_comparison_after_vn.md.)

Слайд 15. Сравнение источников (≈ 40 с)

Сводная таблица всех проверенных каналов. Канал BJT с каскадной постобработкой — выделен
— одновременно проходит все тесты и имеет максимальную минимальную энтропию. Тепловой канал даёт устойчивый средний результат — десять из пятнадцати PASS, но амплитуда сигнала на порядок ниже. Микрофон, MEMS-датчик MPU-6050, плавающий АЦП и канал дрожания тактовых сигналов в наблюдаемой реализации непригодны как самостоятельные источники.

(Важное методическое замечание: плавающий АЦП и clock jitter имеют формально высокую минимальную энтропию ≈ 0,9999, но проваливают все 15 групп NIST STS. Это иллюстрирует, что побитовая минимальная энтропия не учитывает структурных корреляций между битами — источник может иметь высокую H∞ на бит и при этом быть полностью предсказуемым на уровне последовательности. Метрика H∞ необходима, но недостаточна; прохождение NIST STS даёт дополнительную верификацию структурной независимости.

Почему у двух каналов в столбце σadc стоит прочерк. Эти каналы не проходят через АЦП Arduino, поэтому величина σadc (стандартное отклонение в кодах 10-битного АЦП) к ним принципиально неприменима, и прочерк — это корректное обозначение неприменимости метрики, а не «не измерили». MPU-6050. MEMS-датчик ускорения и угловой скорости со встроенным АЦП и интерфейсом I²C. Arduino получает уже готовые 16-битные цифровые отсчёты через шину, аналогового сигнала на пине нет. «Шум» здесь — это дискретные шевеления младших бит выхода датчика, и его естественная мера — не σ в кодах АЦП, а статистика младшего бита: pˆ1 ≈ 0,67, отсюда H∞ ≈ 0,58 и провал почти всех тестов.
Clock jitter. Измерение времени между фронтами тактового сигнала через micros() / счётчик таймера Arduino. Это временна́я величина (интервал ∆t в микросекундах или тиках), а не амплитуда напряжения. АЦП в цепочке вообще не участвует — σadc определить не из чего. Аналог σ для этого канала — это стандартное отклонение интервала ∆t между фронтами в наносекундах (в наших измерениях σ∆t ∼ 2 мкс), но эта величина другой физической размерности и в столбец с амплитудами АЦП не помещается.

То есть прочерк в этой колонке честно означает: «метрика неприменима к данному классу источников». Сравнение всё равно корректно по столбцам H∞, PASS/FAIL NIST STS и скорости генерации — эти три критерия универсальны.)

Слайд 16. Выводы (≈ 35 с)

Резюмирую. Выполнены поставленные задачи: проведён теоретический анализ восьми классов физических источников энтропии, собран стенд и натурно проверены шесть независимых каналов, разработаны и обоснованы пять алгоритмов постобработки, все каналы оценены по NIST STS, минимальной энтропии и скорости генерации.
Главные результаты: дано теоретическое обоснование каскада — корректор фон Неймана строго устраняет смещение в идеальном случае, а XOR-децимация геометрически подавляет остаток и краткосрочные корреляции. На канале лавинного шума BJT с каскадной постобработкой получено пятнадцать из пятнадцати NIST STS без криптографических примитивов; стоимость элементной базы менее пятидесяти рублей.

Слайд 17. Перспективы (≈ 20 с)

Перспективы. Встроенный health-мониторинг в реальном времени — лёгкие тесты стандарта NIST SP 800-90B (Repetition Count и Adaptive Proportion) непосредственно в прошивке, чтобы устройство само детектировало деградацию источника энтропии в процессе работы. XOR-смешение нескольких независимых каналов как дополнительный уровень: пропускная способность не теряется, минимальная энтропия монотонно растёт. Перенос всего конвейера на встроенный микроконтроллер для работы без ПК.

(Health-тесты SP 800-90B по разделу 4.4: Repetition Count Test — проверяет, не повторяется ли одно и то же значение дольше порогового числа раз подряд (детектирует «залипание» источника); Adaptive Proportion Test — следит за частотой каждого значения в скользящем окне W = 512 (детектирует резкое смещение). Оба теста работают за константную память и O(1) операций на отсчёт, что делает их пригодными для микроконтроллера. В отличие от NIST STS (запускается оффлайн на больших выборках), health-тесты дают реакцию в реальном времени и могут поднять флаг ошибки до того, как скомпрометированные данные попадут к потребителю.)
(Left-over hash lemma: для семейства универсальных хэш-функций Hs и случайной величины X с H∞(X) ≥ k выход Hs(X) статистически ε-близок к равномерному при |Hs(X)| ≤ k − 2 log(1/ε). Для XOR-смешения:
P(b

′
1 ⊕ b

′
2 = 1) −

1
2 = 2ε1ε2, аналогично умножению смещений, H∞ выхода не убывает.)

Возможные вопросы и ответы

## Q1. Почему min-entropy почти 1, а NIST STS не проходит на сыром потоке?

Min-entropy — это одномерная статистика: H∞ = − log2 maxx P(X=x) смотрит только на распределение значений на отдельно взятом бите, но ничего не говорит о зависимостях между битами. NIST STS как раз и проверяет такие зависимости: серии (Runs, LongestRun), шаблоны (Template), спектр (FFT), случайные блуждания (RandomExcursions). Источник с H∞ ≈ 0,9999 может иметь идеальное одномерное распределение бита, но при этом длинные коррелированные серии, которые моментально валят тесты на серии и блуждания. То есть высокая min-entropy — необходимое, но не достаточное условие случайности.

## Q2. Почему фон Нейман не устранил корреляцию?

Фон Нейман — отбеливатель смещения, а не декоррелятор. Его утверждение о несмещённости опирается на независимость битов внутри пары (b2i

, b2i+1). Если же есть слабая корреляция между парами, корректор:

- корректно сводит p → 1/2 для каждой пары отдельно;
- но сохраняет структурные корреляции между парами, унаследованные от ограниченной полосы аналогового тракта.

В результате: одномерная статистика идеальна (pˆ = 1/2), но автокорреляция ρˆ(k) для k > 1 остаётся ненулевой. Это и видно по сохранившимся провалам тестов на длинные серии и случайные блуждания.

## Q3. Почему XOR уменьшает корреляцию?

Два эффекта одновременно:

- Умножение смещений (piling-up lemma): P(b1 ⊕ b2 = 1) −
1
2 = −2ε1ε2, малые ε
перемножаются и быстро падают.
- Декорреляция: если автокорреляция входа имеет конечный масштаб L (т. е. ρ(k) → 0 при k > L) и n > L, то XOR объединяет несколько слабо зависимых битов в один выходной, усредняя локальные корреляции внутри окна; соседние выходные биты опираются на непересекающиеся окна и отстоят на ≥ n входных бит, поэтому корреляция между ними падает на порядки.

Поэтому каскад фон Нейман (убирает смещение) + XOR-децимация (убирает остаточные корреляции) даёт 15/15 NIST STS, тогда как ни один из этих шагов в отдельности этого не давал.

## Q4. Почему критерий Пирсона отвергает нормальность, хотя огибающая визуально гауссова?

Эффект размера выборки. Статистика χ

2 =

### ∑(Oi − Ei)

2/Ei растёт пропорционально n при любом фиксированном отклонении эмпирического распределения от модельного. При n = 10⁸ любое реальное физическое распределение отвергается (p≈0) — идеально нормальных данных в природе не бывает. Это общий принцип: p-значение зависит от размера выборки, и при больших n статистический тест замечает даже пренебрежимо малые отклонения, которые визуально незаметны.

## Q5. Почему именно α = 0,01?

NIST SP 800-22 рекомендует α | = | 0,01 как компромисс между мощностью теста и
ложноположительными срабатываниями. Под H0 ровно 1 % под-тестов отвергается «случайно». При 188 под-тестах ожидается ∼ 1–2 ложных провала — это норма. Поэтому критерий приёмки формулируется в терминах групп (15/15), а не отдельных под-тестов: группировка автоматически учитывает проблему множественных сравнений.

## Q6. Почему именно min-entropy, а не Шеннон, для криптографии?

Шеннон H = −

∑px log2
px — это средняя информация на символ. Min-entropy H∞ = − log2 maxx px — гарантия наихудшего случая: вероятность угадать наиболее вероятное значение с первой попытки равна 2

−H∞. Атакующий пробует именно наиболее вероятный ключ — средняя величина H его не сдерживает. Пример: распределение (
| | 1/2, 1/4, 1/4) имеет H = 1,5 бит, но H∞ = 1
бит — вдвое слабее по угадываемости, чем оптимальный двухбитный источник с такой же H. Поэтому NIST SP 800-90B нормирует именно H∞.

## Q7. Чем независимость отличается от некоррелированности?

Некоррелированность: cov(X, Y ) = E[(X − EX)(Y − EY )] = 0 — утверждение только о линейной связи. Независимость сильнее: для любых борелевских f, g выполнено E[f(X)g(Y )] = E[f(X)] E[g(Y )]. Классический пример: X ∼ U[−1, 1], Y = X² — корреляция нулевая, но Y полностью определяется X. В TRNG нужна именно независимость, поэтому помимо ρ обязательно запускаются нелинейные тесты (Template, Approximate Entropy, RandomExcursions) — они ловят зависимости, невидимые автокорреляции.

## Q8. Что такое стационарность и предполагается ли она в работе?

Строгая стационарность: совместное распределение (Xt1

| | , . . . , Xtk ) не зависит от сдвига t →
t + τ . Слабая (стационарность 2-го порядка): EXt и cov(Xt
| | , Xt+k) не зависят от t. В работе
предполагается слабая стационарность в течение каждого набора данных — иначе оценки pˆ, ρˆ(k) не имели бы смысла. Health-тесты (Repetition Count, Adaptive Proportion) как раз детектируют нарушение стационарности в реальном времени — это страховка на случай деградации источника или внешних воздействий.

## Q9. Почему «15/15 групп», а не «188/188 под-тестов»?

По двум причинам:

- Множественные сравнения: при 188 независимых тестах и α = 0,01 ожидается ∼ 2 ложных провала под H0. Требование «все 188 PASS» отбраковало бы даже идеальный источник.
- Группировка по типу зависимости: тесты одной группы ловят однотипные дефекты. Если вся группа красная — это указывает на структурный дефект источника, а не на случайный выброс.

Критерий 15/15 — проверка устойчивости источника по всем классам зависимостей.

## Q10. А если поменять постобработки в каскаде местами?

Каскад некоммутативен: порядок имеет значение и теоретически, и практически. Разберём оба варианта.

Вариант A (наш): фон Нейман → XOR-децимация.

- Фон Нейман на сырых битах с p = 1/2 + ε, ε ∼ 10−3
: выход почти несмещён, но унаследует структурную корреляцию — слабая корреляция в парах нарушает P((0, 1)) = P((1, 0)).
- XOR-8 добивает остаточную корреляцию: окно n = 8 много больше характерной длины корреляции L ∼ 1, биты в окне фактически независимы ⇒ корреляция между XOR-блоками падает на порядки.
- Каждая ступень специализирована: vN убирает смещение, XOR убирает корреляцию.

Вариант B: XOR-децимация → фон Нейман.

- XOR-8 на сырых битах: по лемме об умножении смещений εвых ∼ 2

n−1
ε

n = 2⁷
·
(10−3
)

8 ≈ 10−22 — смещение становится абсолютно пренебрежимым уже на первой ступени. Корреляция также сводится к нулю окном 8 > L.

- На выходе — фактически идеальный Бернулли 1/2, независимый.
- Фон Нейман на таком входе ничего полезного не делает: вход уже идеален, но vN всё равно отбрасывает ∼ 50 % пар. Это чистая потеря пропускной способности.

Сравнение. Пропускная способность одинакова: в обоих вариантах выход ≈ N/32 от входа (N · 1/4 · 1/8 либо N · 1/8 · 1/4). Качество в обоих случаях достаточное для 15/15 NIST STS. Но в варианте B ступень vN становится математически избыточной — логичнее было бы выкинуть её совсем и оставить только XOR-8, получив N/8 битов в 4 раза больше при том же качестве.

Почему именно vN → XOR (вариант A)?

1. Прозрачность дизайна: каждая ступень отвечает за свой класс дефектов, обе математически обоснованы независимо. vN — классический отбеливатель смещения с доказанной несмещённостью при независимости; XOR-децимация — классическая декорреляция через умножение смещений. Удобно для аудита и понимания.

2. Дополнительный эффект «прореживания структуры»: фон Нейман отбрасывает совпадающие пары (0, 0) и (1, 1) неравномерно, в зависимости от локального содержимого потока. Это эквивалентно нерегулярному прореживанию, которое разрушает периодические компоненты автокорреляции и спектральные пики — XOR далее работает на гораздо более «белом» потоке.
3. Устойчивость к усилению корреляции: если бы корреляция тракта оказалась сильнее (например, L соизмеримо с окном XOR), вариант B (XOR в одиночку) перестал бы давать 15/15, а вариант A благодаря предварительному vN остался бы рабочим.
4. Историческая и эталонная схема: каскад «фон Нейман + дополнительная декорреляция» — стандартный приём в TRNG-литературе (Marsaglia, Lacharme, Killmann–Schindler), что облегчает сравнение с другими реализациями и сертификационными требованиями.

Итог: порядок vN → XOR — это не случайный выбор, а специализация ступеней с дополнительным бонусом разрушения структуры АКФ. Обратный порядок даёт то же качество выхода, но vN-ступень в нём математически избыточна.

## Q11. Почему 16-битные отсчёты, если у Arduino АЦП на 10 бит?

АЦП Arduino Nano (ATmega328P) действительно десятиразрядный: выдаёт значения 0 . . . 1023. По сети передаются 16-битные (двухбайтовые) отсчёты, в которых старшие 6 бит — всегда нули. Причин несколько.

- UART байт-ориентирован. Передача идёт по последовательному интерфейсу 8-битными байтами. Чтобы упаковать 10 бит в целое число байтов, минимум = 2 байта = 16 бит. Промежуточные ширины (10, 11, 12 бит) требовали бы битовой упаковки нескольких отсчётов в группу (например, 4 отсчёта по 10 бит в 5 байт), что существенно усложнило бы парсинг на стороне ПК и синхронизацию.
- Фиксированная | ширина | = | простой | парсинг. | На ПК поток читается как
numpy.fromfile(…, dtype=uint16) — одна строка кода. Без выравнивания пришлось бы вводить состояние парсера и буферизацию.
- Архитектура AVR оптимальна для 16 бит. ATmega328P — 8-битное ядро с 16-битными регистрами таймеров и АЦП-регистров ADCL/ADCH. Передача через двухбайтовый uint16_t естественна для прошивки: чтение АЦП даёт сразу два байта в правильном порядке.
- Единый бинарный протокол. Все шесть каналов стенда (BJT, тепловой шум, микрофон, MEMS, плавающий АЦП, clock jitter) отдают данные одного формата — 16-битный little-endian поток. Это делает эксперименты изоморфными: один и тот же ПК-конвейер обрабатывает любой источник. MPU-6050 уже выдаёт 16-битные отсчёты из I²C, а clock jitter — 16-битные тики счётчика; единый формат удобно охватывает все случаи.
- Запас на будущее. Если перейти на 12-разрядный внешний АЦП (MCP3201, MCP3208) или 16-разрядный (ADS1115), формат не меняется: те же 16 бит, просто заполнены все разряды. Конвейер обработки на ПК продолжает работать без изменений — достаточно поменять параметр «сколько младших разрядов брать».

Накладные расходы. В каждом отсчёте 6 бит передаются впустую, что даёт оверхед ∼ 60 % по пропускной способности UART. На скорости 1 Мбод (max для Arduino) теоретический предел ∼ 100 Кбайт/с →∼ 50 Ксэмплов/с при 16-битном формате. На практике мы работаем именно на этой скорости, и потеря в эффективности несущественна по сравнению с выигрышем в простоте.

Источники: что взято из каждой работы

Краткая «карта использования»: где конкретно в работе и для чего понадобился каждый из 14 источников.

1. Android | Security | Vulnerability | (Bitcoin | Alert, | 2013). | Исторический | пример
катастрофического провала ГСЧ: дефект Android SecureRandom сделал предсказуемыми ∼86 % Bitcoin-кошельков того периода. Используется во введении и в спиче на слайде 2 как мотивация для прозрачных и аудируемых источников энтропии.
2. Матвеев Ю. Н. «Цифровая обработка сигналов» (ИТМО, 2013). Базовые понятия ЦОС: спектральный анализ, теорема Винера–Хинчина, автокорреляционная функция, фильтры. Привлекается в гл. 2 при обсуждении ограниченной полосы тракта и в гл. 3 при анализе автокорреляции сырого потока.
3. Будько М. Б. и др. «Методы генерации и тестирования случайных последовательностей» (ИТМО, 2019). Обзор методов TRNG и PRNG, описание корректора фон Неймана и других постобработок. Основной русскоязычный источник по схеме каскадной постобработки — использован в гл. 1 и гл. 3 при формализации алгоритмов.
4. Слеповичев И. И. «Генераторы псевдослучайных чисел» (СГУ, 2017). Систематика ГПСЧ: линейный конгруэнтный, Mersenne Twister, криптографические DRBG. Используется в гл. 1 при разделении понятий ГПСП/ГИСП и обсуждении класса задач, в которых применим каждый тип.
5. Barker E. и др. «A Statistical Test Suite…» (NIST SP 800-22, 2010). Основной нормативный документ: методология NIST STS, формулы статистик всех 15 тестовых групп (T-статистика, χ

2
, p-value), пороги приёмки. Используется в гл. 1 (теория), гл. 3 (постановка экспериментов) и для интерпретации всех результатов NIST STS.
6. Di Mauro J., Salazar E., Scolnik H. D. «Novel CSPRNG» (J. Crypt. Eng., 2022). Современный криптографически стойкий ГПСЧ — альтернатива нашему подходу «прозрачной постобработки». Используется в гл. 1 как контраст: где применимы хэш-функции и блочные шифры в роли отбеливателей, и почему наш каскад не использует криптопримитивы.
7. Архангельская | А. В. | «Квантовые | ГСЧ…» | (СПб, | 2008). | Диссертация | по
высокоскоростным квантовым ГСЧ. Используется в гл. 2 при описании квантового канала энтропии (фотонные источники) — как сравнительный класс с заведомо более высокой стоимостью реализации.
8. Гриненко Т. А. и др. «Статистическое тестирование…NIST STS» (ХНУРЭ, 2019). Практическое русскоязычное руководство по запуску NIST STS, интерпретации p-value, выбору параметров (nbits,streams, M, L). Используется в гл. 3 при настройке пакета sts-2.1.2 и при разборе провалов отдельных под-тестов.
9. Петров Д. О., Буслюк В. В. и др. «Диоды как источник энтропии…» (Брест. ГТУ, 2020). Прямой прототип нашего лавинного канала. Используется в гл. 2 при обосновании выбора лавинного пробоя BE-перехода BJT как источника энтропии и в гл. 3 при выборе конфигурации схемы (стабилитронное смещение, компенсация дрейфа).
10. Григорьев А.Ю. «Методы тестирования…» (УлГУ, 2017). Обзор методов тестирования ГСЧ помимо NIST STS (Diehard, TestU01, ENT). Используется в гл. 1 как обоснование выбора именно NIST STS как стандартизованного и нормативного пакета.
11. Якимов А. В. «Физика шумов и флуктуаций параметров» (ННГУ, 2013). Основной физический источник: тепловой шум Джонсона–Найквиста, дробовой шум Шоттки, фликкер-шум 1/f, лавинный пробой, спектральные плотности. Используется в гл. 2 при выводе формул шумовой мощности для каждого из восьми классов источников.
12. Cao Y. и др. «Entropy Sources Based on Silicon Chips» (Entropy, 2022). Современный обзор кремниевых TRNG: ring-oscillator jitter, метастабильность, лавинный пробой, PUF. Используется в гл. 1 и гл. 2 для контекста «state of the art» и сравнения нашей схемы с промышленными аналогами.
13. Алейник А. С. и др. «Основы схемотехники приёмопередающих электронных устройств» (ИТМО, 2021). Учебник по проектированию усилительных трактов: операционные усилители, обратная связь, частотные характеристики, согласование импедансов. Используется в гл. 3 при расчёте двухкаскадного тракта на LM358 (коэффициент усиления G≈528, полоса, шумовые параметры).
14. Markettos T., Moore S.W. «Frequency Injection Attack on Ring-Oscillator-Based TRNG» (CHES 2009). Атака инжекции частоты: как непрозрачные TRNG на кольцевых генераторах могут быть синхронизованы внешним сигналом и потерять энтропию. Используется в гл. 1 как обоснование принципа «устойчивости к внешним воздействиям» и важности контроля питания (отсюда стабилизация Vcc в нашей схеме).

Группировка по разделам работы.

- Введение и мотивация (актуальность, исторические провалы): [1].
- Теория случайности, классы ГСЧ, методология тестирования (глава 1): [3], [4], [5], [6], [8], [10].
- Физика источников энтропии (глава 2): [2], [7], [9], [11], [12], [14].
- Проектирование стенда и эксперимент (глава 3): [3], [5], [8], [9], [13].
