60mph/vkr_trng/vkr/pandoc_media/media/exp_bjt_2stage/bits_image.png

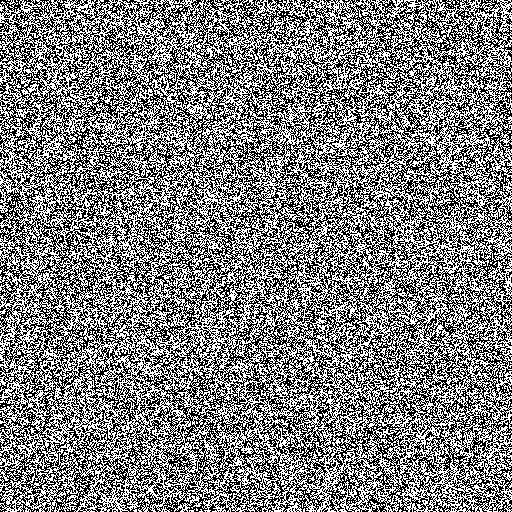
vkr/pandoc_media/media/exp_bjt_2stage/bits_image.png
