60mph/vkr_trng/vkr/pandoc_media/media/exp_bjt_2stage/psd_raw.png

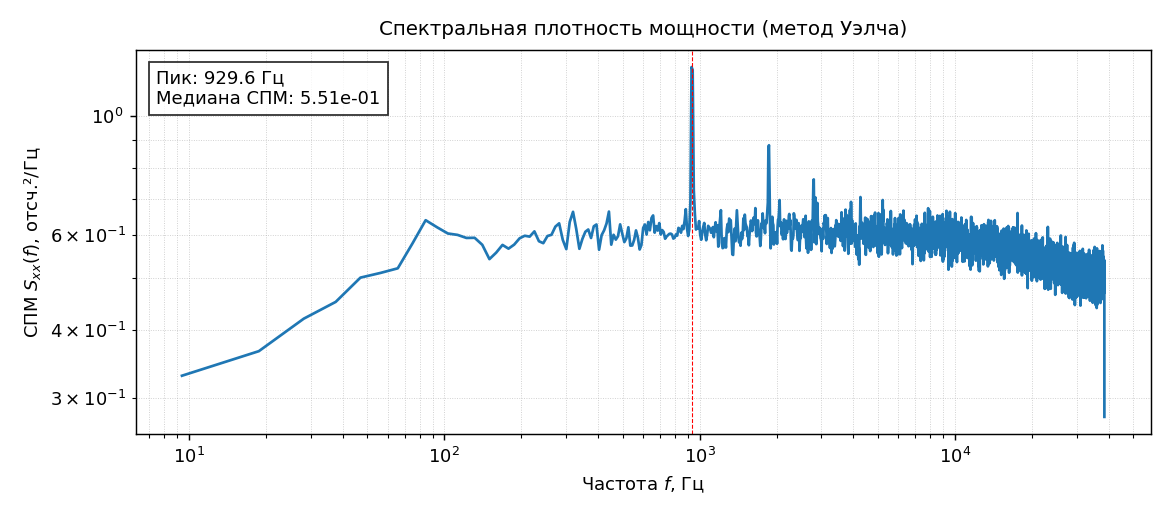
vkr/pandoc_media/media/exp_bjt_2stage/psd_raw.png
