60mph/vkr_trng/vkr/pandoc_media/media/exp_bjt_2stage/scope_time_250ms.png

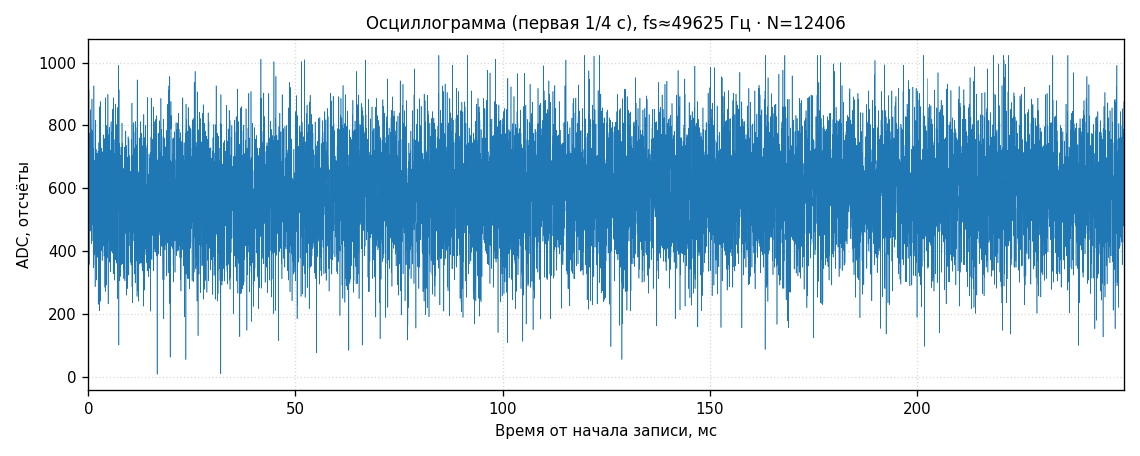
vkr/pandoc_media/media/exp_bjt_2stage/scope_time_250ms.png
