60mph/vkr_trng/vkr/pandoc_media/media/exp_bjt_vcc_stab/scope_time_1s000.png

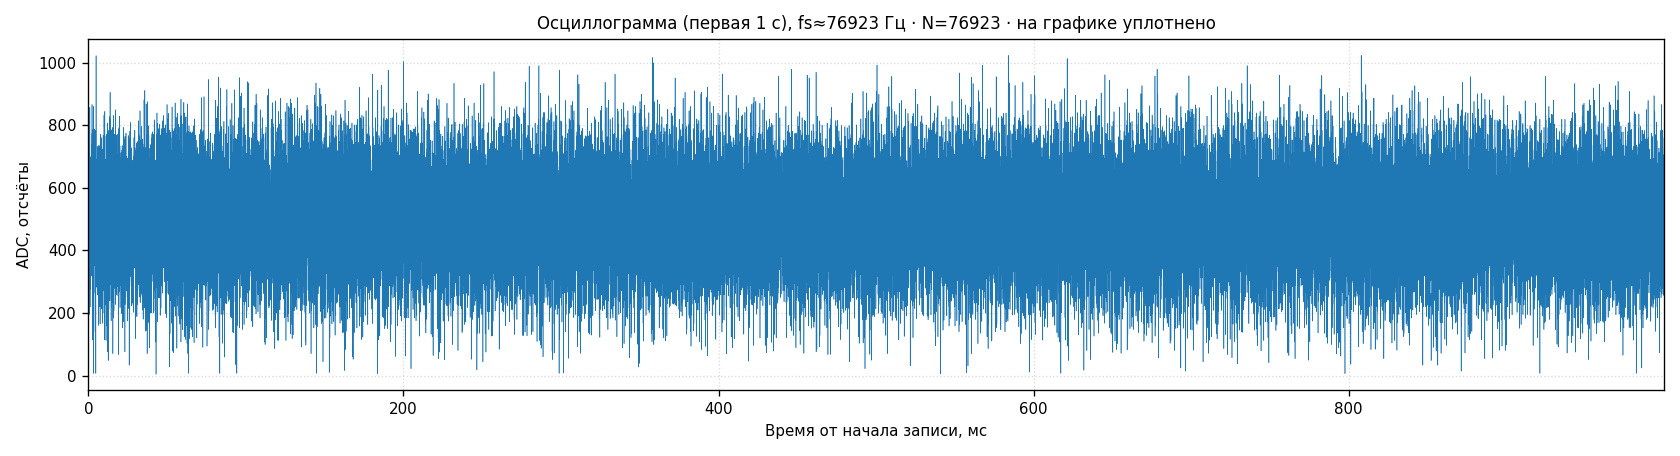
vkr/pandoc_media/media/exp_bjt_vcc_stab/scope_time_1s000.png
