60mph/vkr_trng/vkr/pandoc_media/media/exp_clock_jitter/psd_raw.png

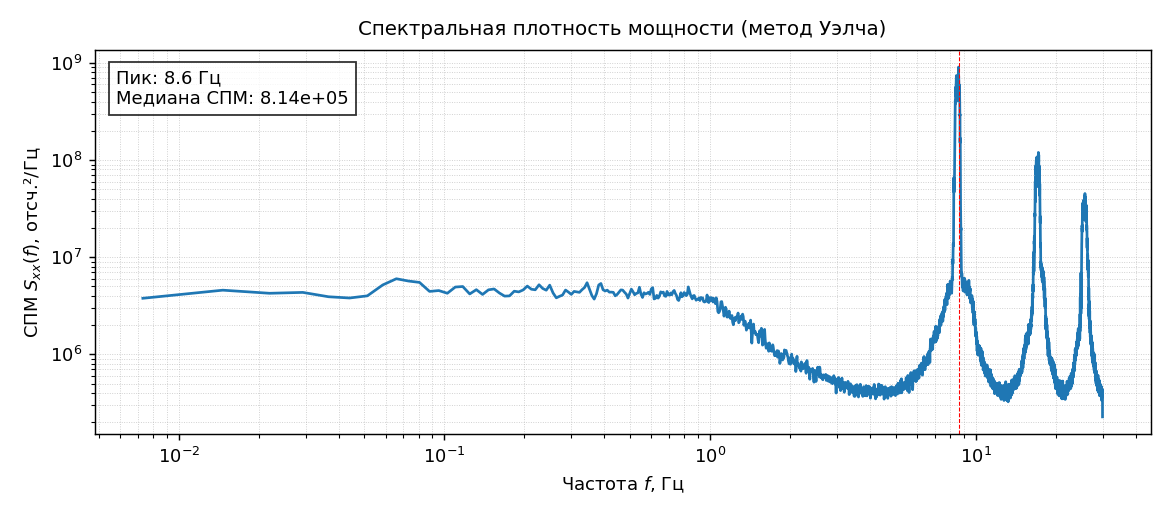
vkr/pandoc_media/media/exp_clock_jitter/psd_raw.png
