60mph/vkr_trng/vkr/pandoc_media/media/exp_clock_jitter/scope_time_1s000.png

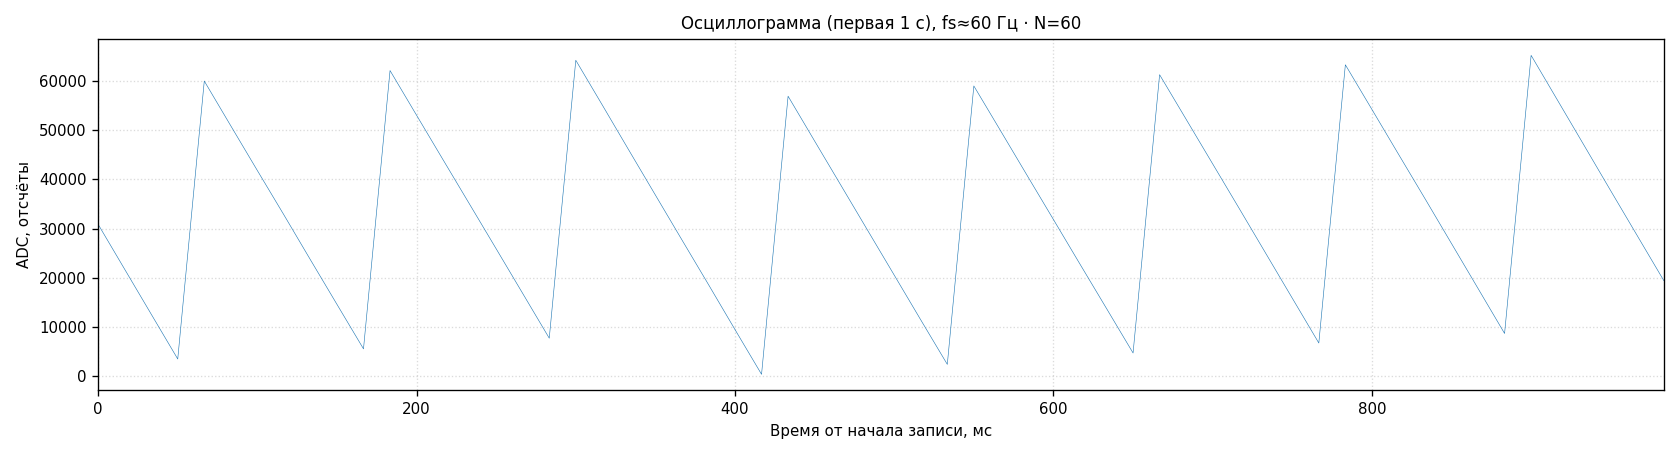
vkr/pandoc_media/media/exp_clock_jitter/scope_time_1s000.png
