60mph/vkr_trng/vkr/pandoc_media/media/exp_floating_adc/psd_raw.png

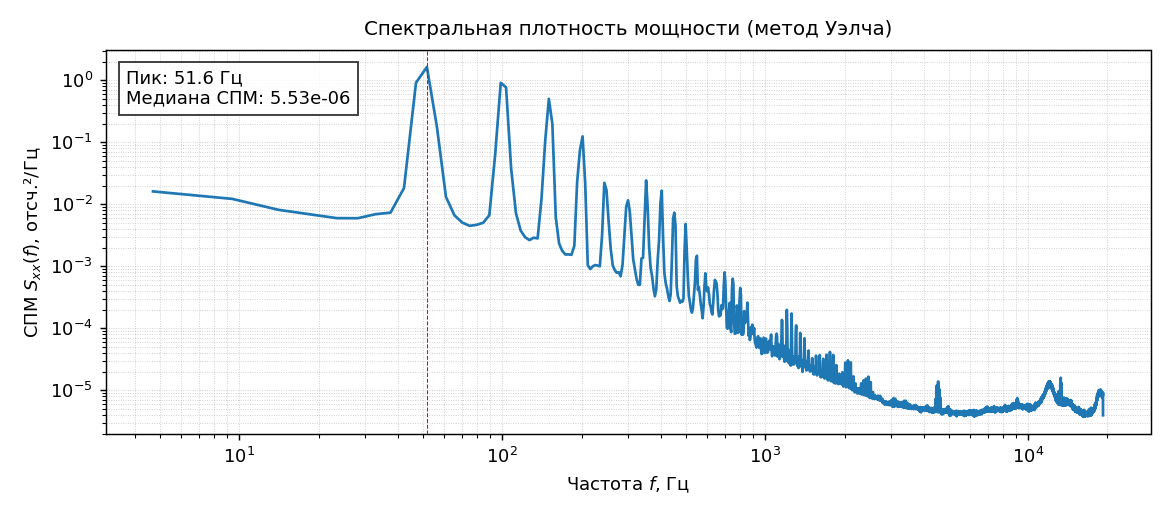
vkr/pandoc_media/media/exp_floating_adc/psd_raw.png
