60mph/vkr_trng/vkr/pandoc_media/media/exp_microphone/autocorr_raw.png

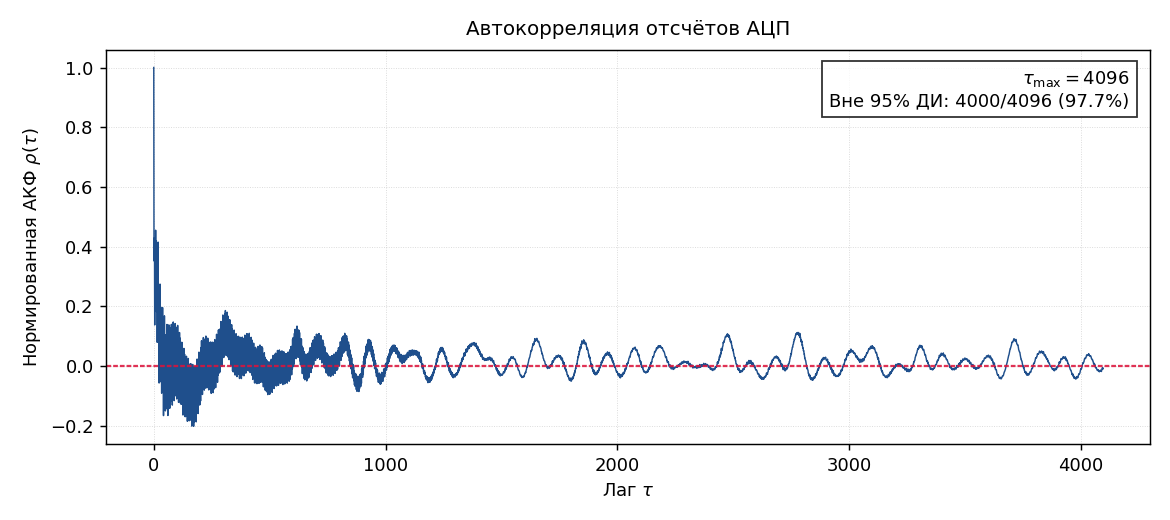
vkr/pandoc_media/media/exp_microphone/autocorr_raw.png
