60mph/vkr_trng/vkr/pandoc_media/media/exp_microphone/bits_image.png

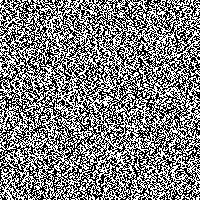
vkr/pandoc_media/media/exp_microphone/bits_image.png
