60mph/vkr_trng/vkr/pandoc_media/media/exp_mpu6050/autocorr_bits.png

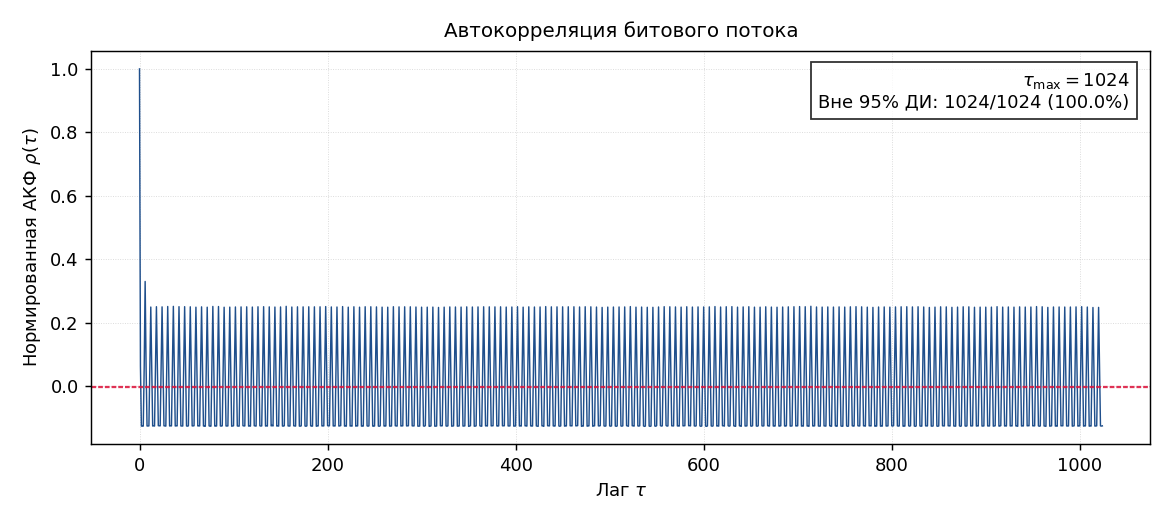
vkr/pandoc_media/media/exp_mpu6050/autocorr_bits.png
