60mph/vkr_trng/vkr/pandoc_media/media/exp_mpu6050/bits_image.png

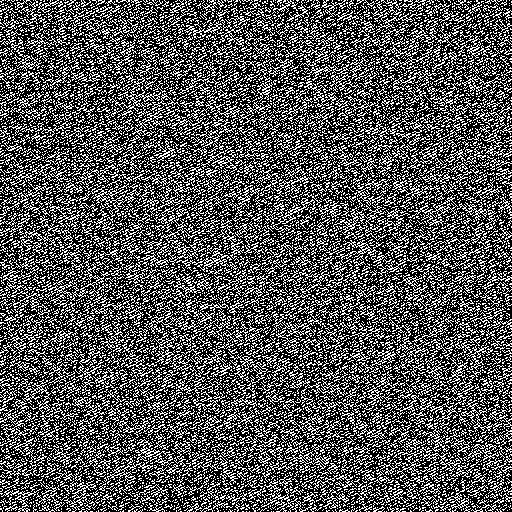
vkr/pandoc_media/media/exp_mpu6050/bits_image.png
