60mph/vkr_trng/vkr/pandoc_media/media/exp_mpu6050/psd_raw.png

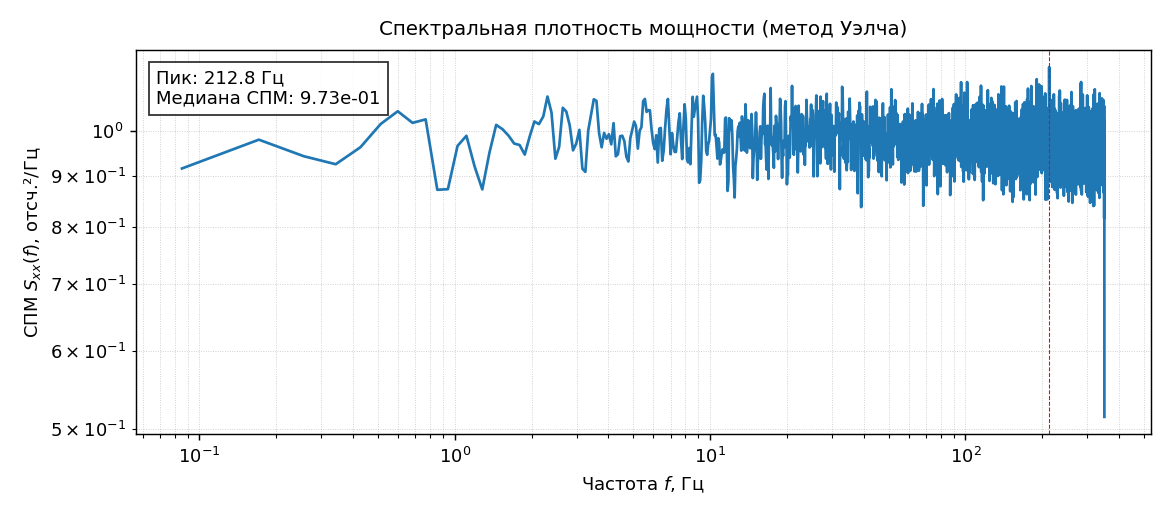
vkr/pandoc_media/media/exp_mpu6050/psd_raw.png
