60mph/vkr_trng/vkr/pandoc_media/media/exp_mpu6050/scope_time_1s000.png

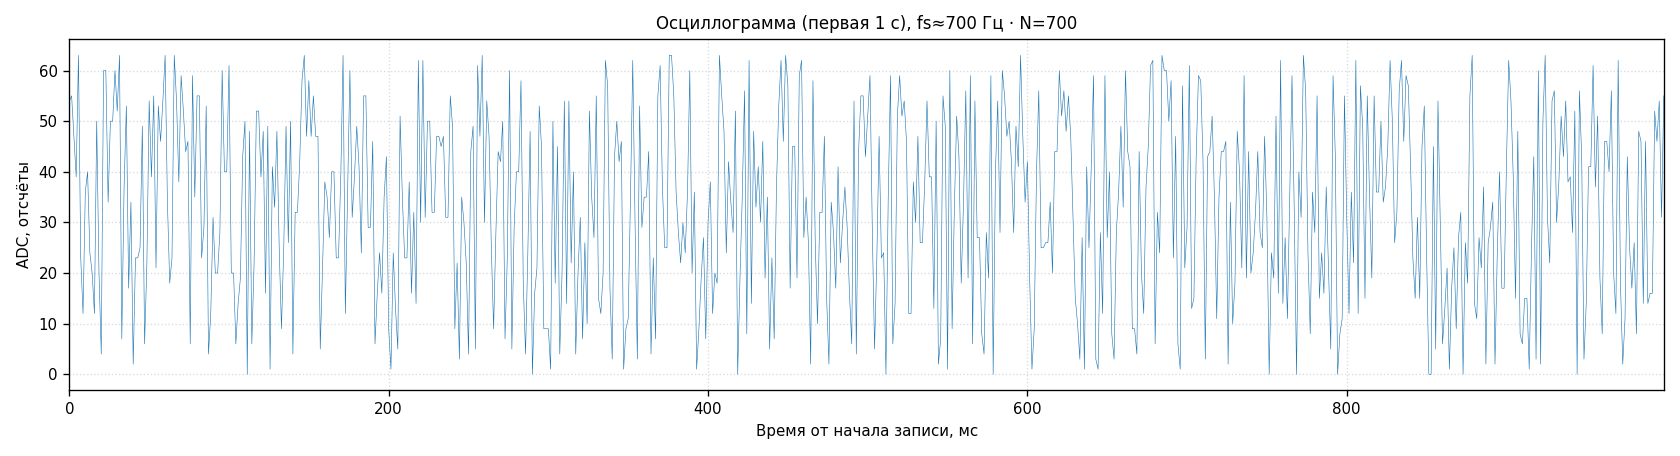
vkr/pandoc_media/media/exp_mpu6050/scope_time_1s000.png
