60mph/vkr_trng/vkr/pandoc_media/media/exp_thermal_new/histogram_raw.png

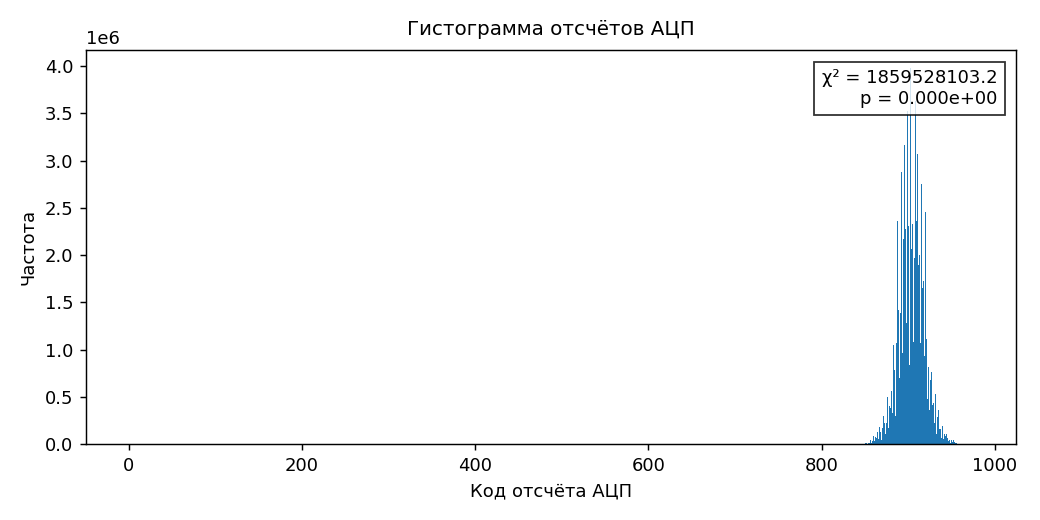
vkr/pandoc_media/media/exp_thermal_new/histogram_raw.png
