60mph/vkr_trng/vkr/pandoc_media/media/exp_thermal_new/psd_raw.png

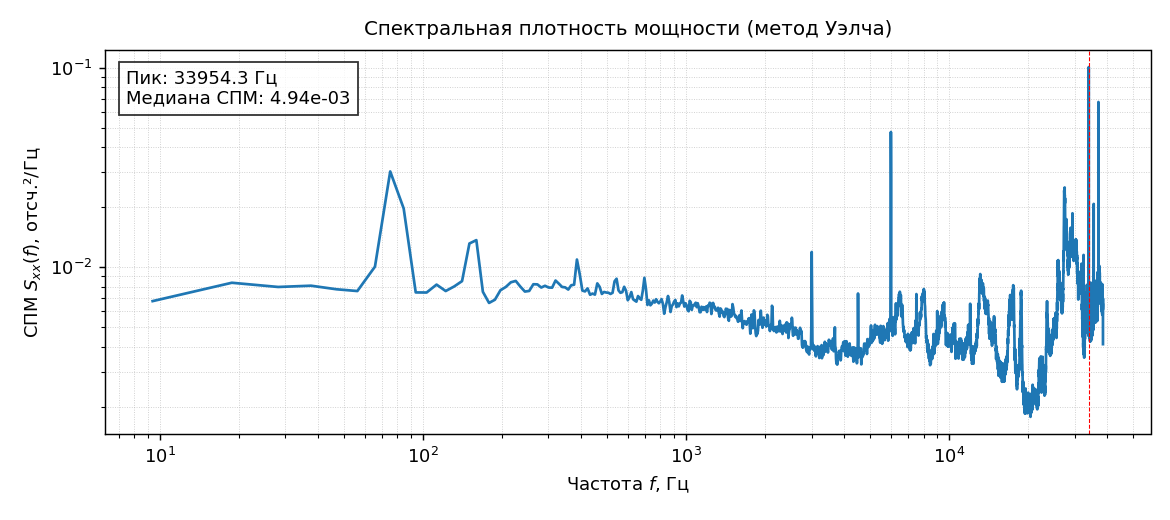
vkr/pandoc_media/media/exp_thermal_new/psd_raw.png
