60mph/vkr_trng/vkr/pandoc_media/media/exp_thermal_new/scope_time_125ms.png

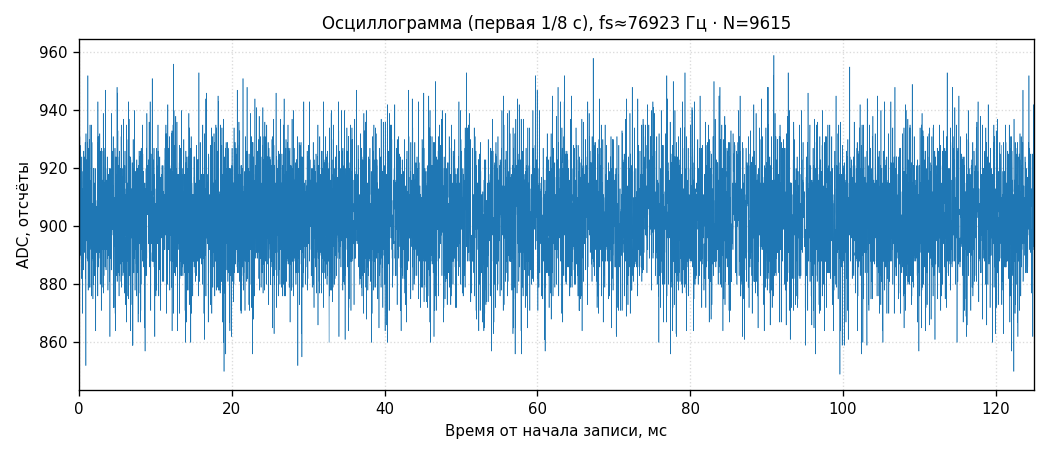
vkr/pandoc_media/media/exp_thermal_new/scope_time_125ms.png
