60mph/vkr_trng/vkr/pandoc_media/media/thermal_three_exp/plots/exp2_autocorr_raw.png

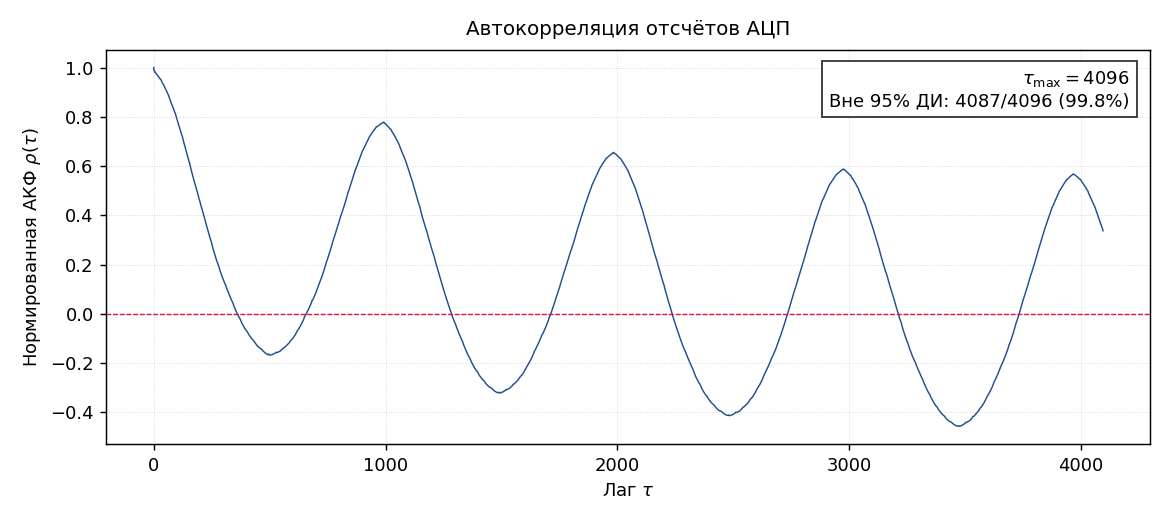
vkr/pandoc_media/media/thermal_three_exp/plots/exp2_autocorr_raw.png
