60mph/vkr_trng/vkr/pandoc_media/media/thermal_three_exp/plots/exp2_histogram_raw.png

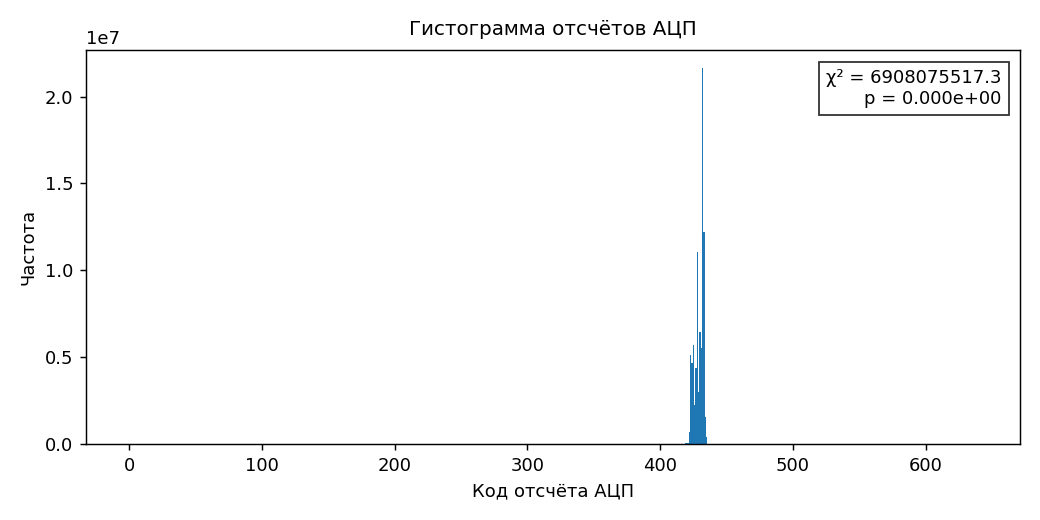
vkr/pandoc_media/media/thermal_three_exp/plots/exp2_histogram_raw.png
