60mph/vkr_trng/vkr/pandoc_media/media/thermal_three_exp/schematic_dual_stage.png

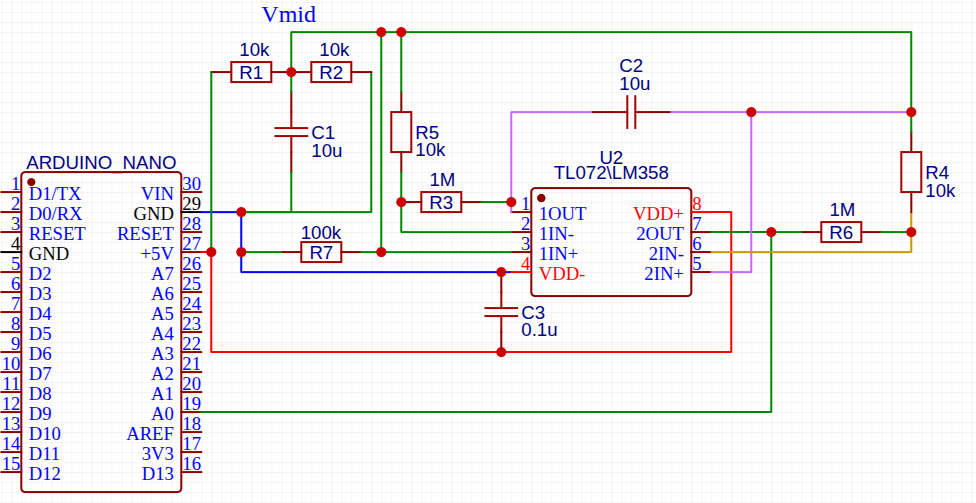
vkr/pandoc_media/media/thermal_three_exp/schematic_dual_stage.png
