60mph/vkr_trng/vkr/parts/01-title.tex

\begin{titlepage}
\thispagestyle{empty}
\centering
\singlespacing
\normalfont

{\small
Министерство науки и высшего образования Российской Федерации\par\vspace{0.5em}
федеральное государственное бюджетное образовательное учреждение высшего образования\par\vspace{0.5em}
{\large\bfseries «Ярославский государственный университет\\
имени П.\,Г.\,Демидова»}\par\vspace{0.7em}
\bfseries Математический факультет\par\vspace{0.35em}
{\mdseries Кафедра математического моделирования}%
}

\vspace{1.8cm}

{\large\bfseries Выпускная квалификационная работа}\par\vspace{1.1em}

{\large\bfseries на тему:}\par\vspace{0.55em}
{\Large\bfseries Разработка концепции физического генератора случайных чисел\par}

\vspace{1.1cm}

{\large
Направление подготовки 01.03.02\par\vspace{0.25em}
«Прикладная математика и информатика»\par\vspace{0.55em}
группа ПМИ-41БО%
}

\vfill

\newcommand{\crsSignBlock}[1]{%
  \underline{\hspace{2.9cm}}\ /\ \makebox[3.2cm][l]{#1}\par
  \makebox[2.9cm][c]{\emph{(подпись)}}\hspace{1.1em}\makebox[3.2cm][c]{\emph{(Ф.\,И.\,О.)}}%
}

\begingroup\small
\noindent\begin{minipage}[t]{0.40\linewidth}
\textbf{Заведующий кафедрой}\par
математического моделирования\par\vspace{0.2em}
д.ф.-м.н., доцент\par\vspace{0.6em}
\crsSignBlock{И.\,С.\,Кащенко}%
\end{minipage}\hfill
\begin{minipage}[t]{0.40\linewidth}\raggedright
\textbf{Научный руководитель}\par\vspace{0.2em}
старший преподаватель\par\vspace{0.6em}
\crsSignBlock{Д.\,А.\,Савинов}\par\vspace{1em}

\textbf{Выполнил}\par\vspace{0.2em}
студент группы ПМИ-41БО\par\vspace{0.6em}
\crsSignBlock{В.\,Д.\,Шестаков}%
\end{minipage}
\endgroup

\vspace{1.5cm}

\textbf{Ярославль}\par\vspace{0.25em}
\textbf{2026}
\end{titlepage}
