60mph/vkr_trng/trng/hardware/components.md

# Каталог компонентов проекта

Перечень и параметры всех используемых деталей. Все источники энтропии в
проекте собираются строго из этой подборки — поэтому каждая прошивка и каждая
схема в `hardware/` ссылается сюда.

## 1. Arduino Nano V3.0 (ATmega328P, USB-C, FT232)

| Параметр | Значение |
|---|---|
| Микроконтроллер | ATmega328P |
| Тактовая частота | 16 МГц (внешний кварц) |
| Логическое напряжение | 5 В |
| ADC | 10 бит, 6 каналов (A0–A5), V_ref = 5 В по умолчанию |
| Опорное (точное) ADC | внутреннее 1.1 В (через `analogReference(INTERNAL)`) |
| Free-running ADC | до ~76 квыб/с при `ADPS = 4` (prescaler 16) |
| I²C | A4 (SDA), A5 (SCL) |
| UART (USB) | до 1 Мбит/с (FT232/CH340) |

### Распиновка (используемая в проекте)

| Пин Arduino | Назначение |
|---|---|
| A0 | Аналоговый вход — выход LM358 / KY-037 / floating|
| A4 (SDA) | I²C к MPU-6050 |
| A5 (SCL) | I²C к MPU-6050 |
| 3V3 | Питание MPU-6050 |
| 5V | Питание LM358 (V+), KY-037 |
| GND | Общий |
| AREF | Опорное напряжение (если внешнее) |
| D2 | Тактовый выход для сравнения (clock jitter) |

### Важные замечания по ADC ATmega328P

- Эффективное число бит ADC ≈ 9 (последний бит шумный даже без сигнала —
  это бесплатно даёт нам источник энтропии №6).
- При `analogRead()` цикл составляет ~104 мкс. Для энтропийного захвата
  используем **free-running ADC** (см. `firmware/common/adc_fast.h`).
- Входной импеданс ADC ≤ 10 кОм (выше — источник «не тянет» S/H, появятся
  артефакты). Поэтому для теплового шума на 1 МОм **обязателен буфер/усилитель на LM358**.

## 2. LM358P — сдвоенный операционный усилитель (5 шт)

| Параметр | Значение |
|---|---|
| Полоса пропускания | ~1 МГц (GBW, тип.) |
| Скорость нарастания | ~0,3 В/мкс (тип.)|
| Входной ток смещения | ~20…80 нА (тип.; выше, чем у JFET-ОУ) |
| Общий диапазон входа (один «+» источник) | включает **GND**, верх ~**(V+ − 1,5 В)** |
| Выход (Rail-to-Rail нет) | низ: близко к **GND**; верх: типично **V+ − 1,5 В** при +5 В ≈ **~3,5 В** |
| Питание | **одно** 3…32 В **или** двухполярное; в проекте **+5 В / GND** |
| Корпус | DIP-8 |

### Распиновка DIP-8

Распиновка совпадает с привычным «двойным ОУ» в DIP-8 (как у распространённых TL072/LM358):

```
        ┌──┐
OUT_A 1 │  │ 8 V+
 IN-A 2 │  │ 7 OUT_B
 IN+A 3 │  │ 6 IN-B
   V- 4 │  │ 5 IN+B
        └──┘
```

В **однополярной** схеме питания 0–5 В от Arduino:
- V+ = 5 В (Arduino 5V), V- = GND.
- Виртуальная середина V_mid = 2,5 В формируется делителем 2× 10 кОм
  с шунтирующим конденсатором 10 мкФ.
- На узлах с **многомегомными** резисторами (тепловой шум) учитывайте **падение от I_bias**
  — при необходимости добавляйте отдельную **высокоомную** подтяжку **V_mid → +IN**
  (см. `01_thermal.md` / «Известные проблемы»).
- **Запас по выходу** до **+5 В невелик**: пики выше **~3,5 В** клиппуют; при насыщении
  уменьшайте номиналы **R_f*** или общее усиление.

## 3. MPU-6050 (модуль GY-521)

| Параметр | Значение |
|---|---|
| Шина | I²C (адрес 0x68 при AD0=GND) |
| Питание модуля | 3.3–5 В (на модуле GY-521 LDO 3.3 В)  |
| Акселерометр | ±2/±4/±8/±16 g, 16 бит |
| Гироскоп | ±250/±500/±1000/±2000 °/с, 16 бит |
| Шум акселерометра | ~400 мкg/√Гц (типичный) |
| Шум гироскопа | ~0.05 °/с/√Гц |

### Подключение

| GY-521 | Arduino Nano |
|---|---|
| VCC | 5V (через LDO модуля становится 3.3В) |
| GND | GND |
| SCL | A5 |
| SDA | A4 |
| AD0 | GND (адрес 0x68) |

Для ГИСП используются **младшие биты** сырых регистров `ACCEL_*`/`GYRO_*` —
именно они доминируются шумом, а не сигналом ускорения/угловой скорости.

## 4. KY-037 (модуль микрофона с компаратором)

| Параметр | Значение |
|---|---|
| Питание | 3.3–5 В |
| Чувствительность| настраивается потенциометром |
| Аналоговый выход| AO — напряжение пропорционально амплитуде |
| Цифровой выход | DO — порог компаратора (не используем) |

| KY-037 | Arduino Nano |
|---|---|
| VCC | 5V |
| GND | GND |
| AO | A0 |
| DO | (не подключаем) |

## 5. Стабилитроны 5,1 В 1 Вт (10 шт)

Используются в **обратном включении** для получения шума Зенера/лавинного
шума. При U_питания ≈ U_z пробой нестабильный → шумный → подходит как источник
энтропии. Для усиления связки нужны связь по AC и LM358 с большим коэффициентом.

## 6. Транзисторы (200 шт, 10 видов по 20)

| Тип | Тип транзистора | U_BE_breakdown (typ) | Применение в проекте |
|---|---|---|---|
| BC337  | NPN | ~5–7 В | усилитель / лавинный шум |
| BC327  | PNP | ~5–7 В | парный к BC337 |
| 2N2222 | NPN | ~6–7 В | классический ГИСП на BE |
| 2N2907 | PNP | ~6–7 В | парный к 2N2222 |
| 2N3904 | NPN | ~6–9 В | основной NPN, стабильно шумит |
| 2N3906 | PNP | ~5–7 В | парный к 2N3904 |
| S8050  | NPN | ~5–7 В | взаимозаменяем с BC337 |
| S8550  | PNP | ~5–7 В | взаимозаменяем с BC327 |
| A1015  | PNP | ~5–7 В | малосигнальный |
| C1815  | NPN | ~5–7 В | малосигнальный |

> **Ключевая идея**: при подаче на BE-переход BJT обратного напряжения 7–9 В
> переход уходит в лавинный пробой, давая широкополосный шум с амплитудой,
> сильно превосходящей тепловой. Это классическая схема (см. `02_zener.md`,
> `03_bjt_avalanche.md`). На 5 В от Arduino пробой достижим только у некоторых
> экземпляров; стабильнее работать с внешним 9 В блоком питания через Vin.

## 7. Резисторы (600 шт, 30 номиналов 0.25 Вт, 1 %, 10 Ом — 1 МОм)

Используются:

- **R_termal = 1 МОм** — генерация теплового шума, на входе LM358.
- **R_load = 1–10 МОм** — нагрузка стабилитрона/BJT в обратном включении.
- **Делители 10 кОм / 10 кОм** — формирование V_mid = 2.5 В.
- **R_feedback** разных номиналов (1 кОм … 1 МОм) — задают коэффициент
  усиления каскадов LM358.

## 8. Электролитические конденсаторы (120 шт, 0,22 мкФ — 470 мкФ)

- **10–22 мкФ** — связь по AC между каскадами усиления.
- **470 мкФ** — фильтр питания.
- **1–10 мкФ** — шунт виртуальной средней точки.

## 9. Керамические конденсаторы 0,1 мкФ 50 В X7R (10 шт)

Шунты по питанию (LM358 V+, MPU-6050 VCC, рядом с пинами питания Arduino).

## 10. Макетная плата MB-102 (830 контактов)

Вмещает все источники одновременно. Рекомендуется выделять отдельные **рельсы**
питания для аналоговой и цифровой части (одну сторону для V+/V_mid/GND
аналоговой, другую — для 5 В Arduino), соединяя их в единственной точке у
GND-пина Arduino.

## 11. Печатная плата 5×7 см двухсторонняя (3 шт)

Под финальные экземпляры лучших источников после отладки на макетной плате.

## 12. Провода Dupont 10 см (120 шт, по 40 шт M-M, M-F, F-F)

## 13. Провод одножильный 0.55 мм

Для коротких пайков на печатной плате 5×7 см и для перемычек на макетной
плате (короче и стабильнее, чем Dupont).

## Что **не** входит в проект

- ICSP-программатор — не нужен, прошиваем по USB через bootloader.
- Внешний АЦП — все источники укладываются в 10-бит ADC ATmega328P
  (низкая скорость компенсируется длительной записью).
- Источник высокого напряжения — мы не выходим за пределы 9 В.
