60mph/vkr_trng/vkr/pandoc_media/media/trng_microphone/microphone_wiring.png

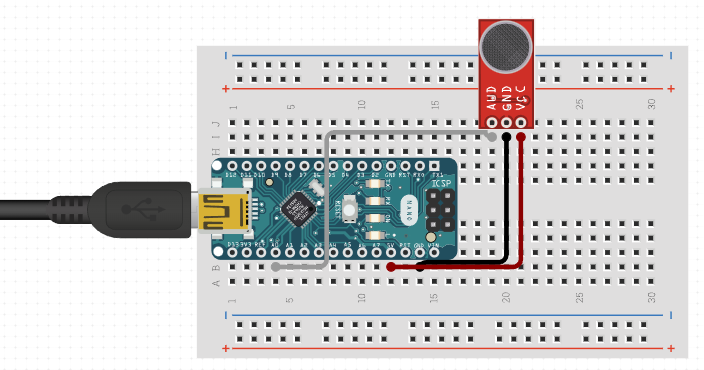
vkr/pandoc_media/media/trng_microphone/microphone_wiring.png
