60mph/vkr_trng/trng/docs/01_thermal_three_experiments.md

# Замеры теплового шума (разные ОУ, усиление, R_n)

Общая разводка — **два неинвертирующих** каскада как в `hardware/01_thermal.md`
(номиналы ниже меняются по экспериментам). Конденсаторы **C1, C2, C3** и **V_mid**
— как в основной методичке.

---

## Эксперимент 4 — **TL072**, **слабое усиление**, **R_n = 1 МОм**

| Позиция | Номинал | Подключение |
|---|---|---|
| R_n | **1 МОм** | **GND ↔ пин 3** (+IN_A) |
| R_f1 | **100 кОм** | **пин 1 ↔ пин 2** |
| R_g1 | **10 кОм** | **пин 2 ↔ V_mid** → Au1 = 1 + 100/10 = **11** |
| C2 | 10 µF | **+ → пин 1**, **− → R_g2** |
| R_g2 | **10 кОм** | **к пину 6** (−IN_B) |
| R_f2 | **300 кОм** | **пин 6 ↔ пин 7** → Au2 = 1 + 300/10 = **31** |
| **+IN_B** | — | **пин 5 ↔ V_mid** |

Итого **Au ≈ 11 × 31 ≈ 341** (ниже, чем в эксп. 1–2, меньше риск насыщения на **TL072** при **+5 В**).

Прошивка: **`firmware/01_thermal/01_thermal.ino`**, **1 Mbd**. Порт свободен.

Полный прогон (двойной NIST LSB + VN, как у полных тепловых замеров):

```bash
cd trng
rm -rf data/raw/01_thermal_exp4_tl072_lowgain \
       data/processed/01_thermal_exp4_tl072_lowgain \
       data/reports/01_thermal_exp4_tl072_lowgain   # опционально, чистый прогон

python3 scripts/pipeline.py --source 01_thermal_exp4_tl072_lowgain \
  --port /dev/ttyUSB0 --baud 1000000 \
  --bits 1 --nist-dual --auto-bytes-for-nist
```

Результат: `data/reports/01_thermal_exp4_tl072_lowgain/`.

---

## Ранее: эксперименты 1–3

Ниже — три исходные конфигурации (**R_n = 100 кОм**, усиление как в базовой методичке)
с полными таблицами и командами пайплайна.

## Общая разводка (эксп. 1 — базовая схема с **100 кОм** R_n)

| Позиция | Номинал | Подключение |
|---|---|---|
| R_n | **100 кОм** | **GND ↔ пин 3** (+IN_A), короткие провода |
| R_f1 | **1 МОм** | **пин 1 ↔ пин 2** (OUT_A ↔ −IN_A) |
| R_g1 | **10 кОм** | **пин 2 ↔ V_mid** |
| C2 | 10 µF | **+ → пин 1**, **− → R_g2**; **R_g2 10 кОм → пин 6** (−IN_B) |
| R_f2 | **1 МОм** | **пин 6 ↔ пин 7** |
| **+IN_B** | — | **пин 5 ↔ V_mid** (это не «10 кОм на V_mid с шестой ноги») |

Усиление: Au1 ≈ 1 + 1M/10k = **101**, Au2 ≈ **101**, всего ≈ **10² × 10²**.

Конденсаторы **C1, C3** и делитель **V_mid** — как в основной схеме.

---

## Общая процедура

1. Соберите цепь, прошейте **`firmware/01_thermal/01_thermal.ino`** (скорость UART **1 Мбит/с**, баннер `BEGIN`).
2. Закройте монитор порта (`picocom` / IDE), иначе захват не откроет `/dev/ttyUSB0`.
3. Запустите пайплайн (пример ниже). В логах будет `→ python capture/...`.

---

### Эксперимент 1 — **LM358**, R_f1 = **1 МОм**

- Сейчас на плате: **LM358** и таблица номиналов выше.
- Захват и отчёт в отдельную папку, чтобы не перезаписать следующие прогоны:

Рекомендуемая одна команда (≈20 МБ raw — хватает на **NIST с 10 потоками** по цепочке LSB):

```bash
cd trng
python3 scripts/pipeline.py --source 01_thermal_exp1_lm358 \
  --port /dev/ttyUSB0 --baud 1000000 --bytes 20971520 --bits 1 --nist
```

Короткий прогон (**10 МБ** raw): гистограмма, PSD, Von Neumann и картинка бит будут в отчёте, но **стандартный NIST** (10×1M бит) не влезет без увеличения `--bytes`. Вариант «урезанный STS» см. в `scripts/pipeline.py --help` (`--streams 1` и т.д.).

Результат: `data/reports/01_thermal_exp1_lm358/`.

---

### Когда менять LM358 → TL072

**После того как первый прогон полностью закончится** (в терминале строка вида «Все артефакты — в …»).

1. **Обесточьте** макетку / отключите USB.
2. Замените **LM358** на **TL072** в том же DIP-8 (проверьте **питание 8→+5V, 4→GND**).
3. Оставьте **те же резисторы** (100k, 1M, 10k и т.д.).
4. Снова прошейте `01_thermal.ino` (при необходимости).
5. Запуск **эксперимента 2**:

```bash
python3 scripts/pipeline.py --source 01_thermal_exp2_tl072 \
  --port /dev/ttyUSB0 --baud 1000000 --bytes 20971520 --bits 1 --nist
```

Результат: `data/reports/01_thermal_exp2_tl072/`.

---

### Когда менять R_f1: **1 МОм → 10 МОм** (только LM358)

**После завершения эксперимента 2.**

1. Снова поставьте **LM358** (как в замере 1).
2. Резистор **между пином 1 и пином 2** замените с **1 МОм** на **10 МОм** (остальная схема без изменений).  
   Au1 ≈ 1 + 10M/10k = **1001** — сильнее усиление, больше риска насыщения/ВЧ-артефактов; это **сравнительный** замер «пошуметь», не эталон «чистого» Johnson noise.
3. Прошивка та же — `01_thermal.ino`.
4. Прогон **эксперимента 3**:

```bash
python3 scripts/pipeline.py --source 01_thermal_exp3_lm358_rf10M \
  --port /dev/ttyUSB0 --baud 1000000 --bytes 20971520 --bits 1 --nist
```

Результат: `data/reports/01_thermal_exp3_lm358_rf10M/`.

---

## Памятка

- Тестовая прошивка `01_thermal_test` для мониторa **не** подходит для пайплайна: нужен поток с `BEGIN` и `uint16le`, как в `01_thermal.ino`.
- Если захват ругается на порт — проверьте `lsof /dev/ttyUSB0` и закройте процесс.
- При старом загрузчике Nano: в `arduino-cli` FQBN `arduino:avr:nano:cpu=atmega328old`.
