60mph/vkr_trng/vkr/pandoc_media/media/exp_bjt_bias_tune/bits_image.png

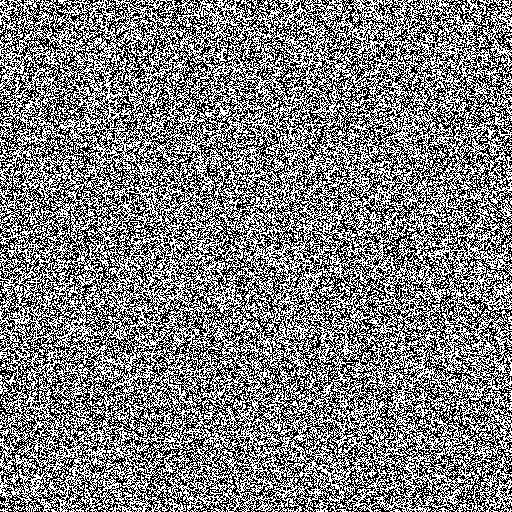
vkr/pandoc_media/media/exp_bjt_bias_tune/bits_image.png
