60mph/vkr_trng/vkr/pandoc_media/media/exp_bjt_bias_tune/psd_raw.png

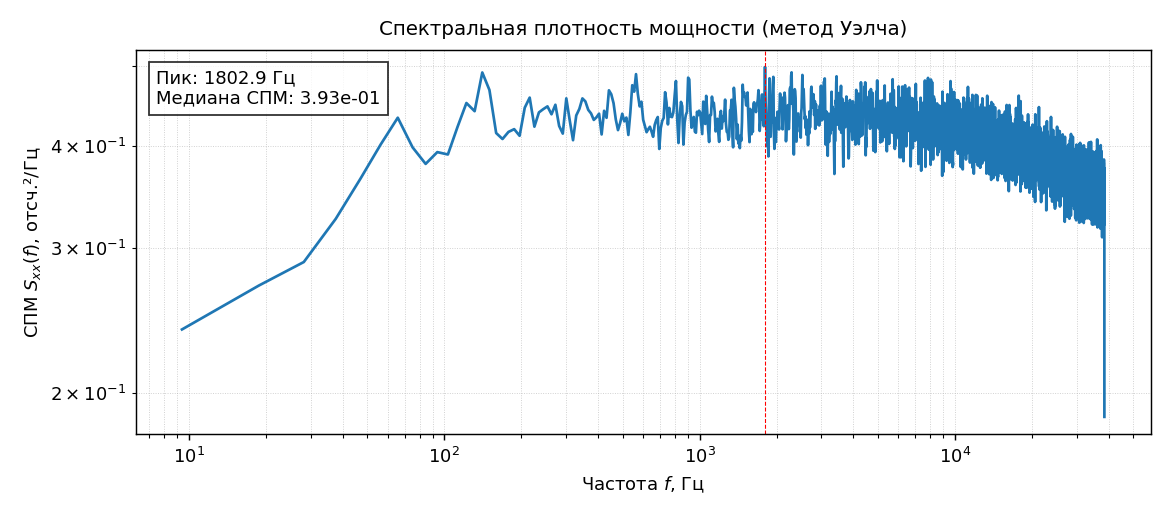
vkr/pandoc_media/media/exp_bjt_bias_tune/psd_raw.png
