60mph/vkr_trng/vkr/pandoc_media/media/exp_bjt_bias_tune/scope_time_1s000.png

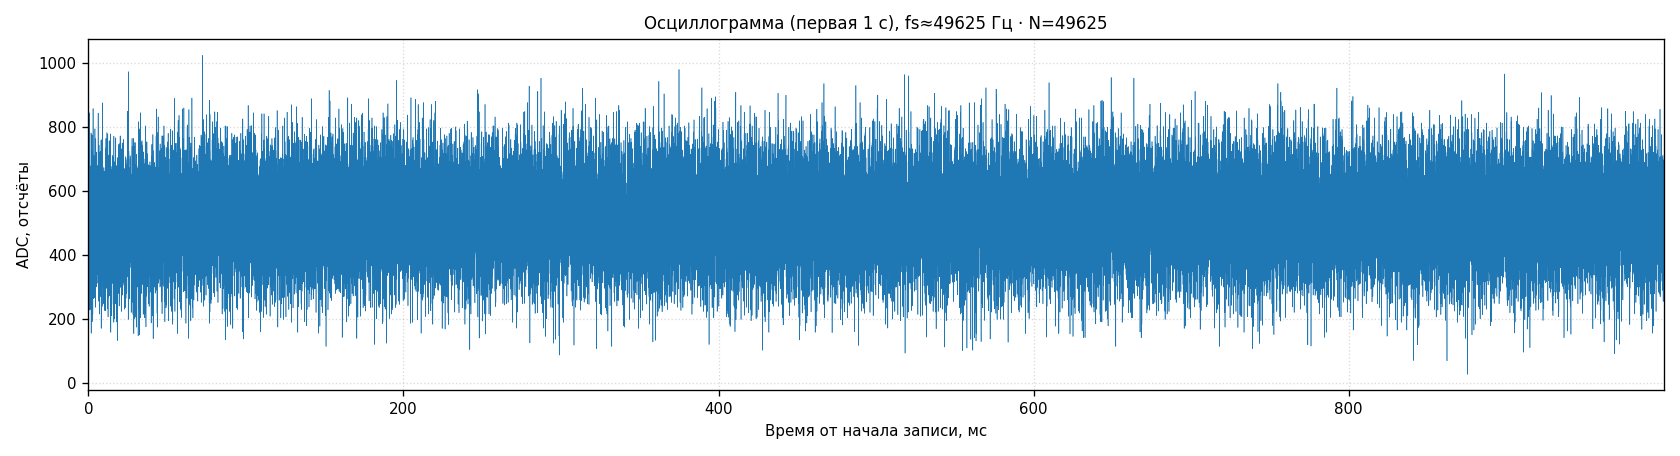
vkr/pandoc_media/media/exp_bjt_bias_tune/scope_time_1s000.png
