60mph/vkr_trng/(commit log)

2026-05-04 Конвертация в латех
2026-05-04 Аккуратно прибрал латех и исправил неодчёты конвертации
2026-05-12 Проги для получения и тестирования энтропии + дока
2026-05-12 Вывод изображения битового потока
2026-05-12 Основы практического получения энтропии и акустический источник
2026-05-23 куча экспериментов
2026-05-23 Текстовое описание экспериментов (нет стабилитрона, нет микрофона)
2026-05-25 Убрал лишние комменты
2026-05-28 стр 43 — последовательная линия — сиречь COM-порт — вроде ограничена 114 кбод, откуда странные 10 в 6 степени ?
2026-05-28 Правки + содержание
2026-06-07 Презенташка + спич + исправления
2026-06-09 Исправление презентации, выступления и текста (перед предзащитой)
2026-06-16 Титульник + шрифт таймс
2026-06-22 Финальные правки самой работы и печать
2026-06-24 Правки презентации и выступления перед защитой
2026-06-24 Презентация финал, выступление текст правки
